Alexhuge1/Alexbotmini_hardware/1_Mechanic/Alexbotmini(SW2URDF)/4_Photos/alexbotmini_stand.jpg

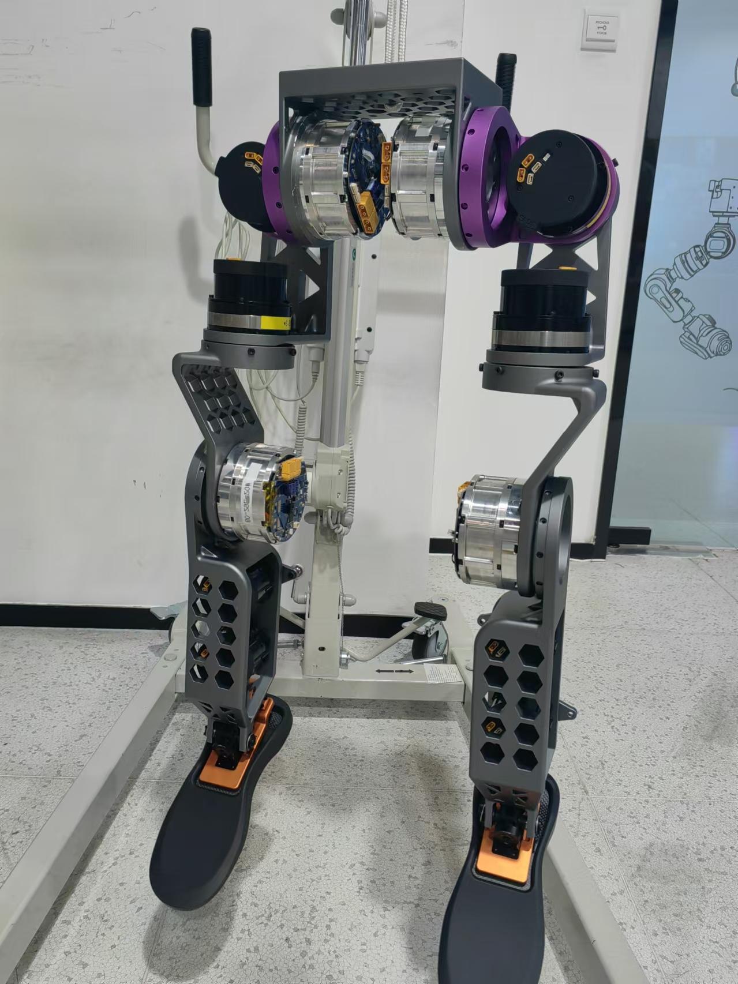
1_Mechanic/Alexbotmini(SW2URDF)/4_Photos/alexbotmini_stand.jpg
