Alexhuge1/Alexbotmini_hardware/1_Mechanic/Alexbotmini_website/Readme.txt

打开keyshot.23.html可以查看alexbotmini的建模文件
You can view the modeling files of Alexbotmini by opening keyshot.23.html.
