Alexhuge1/Alexbotmini_hardware/1_Mechanic/Alexbotmini(SW2URDF)/urdf_refine(mustread)！.pdf

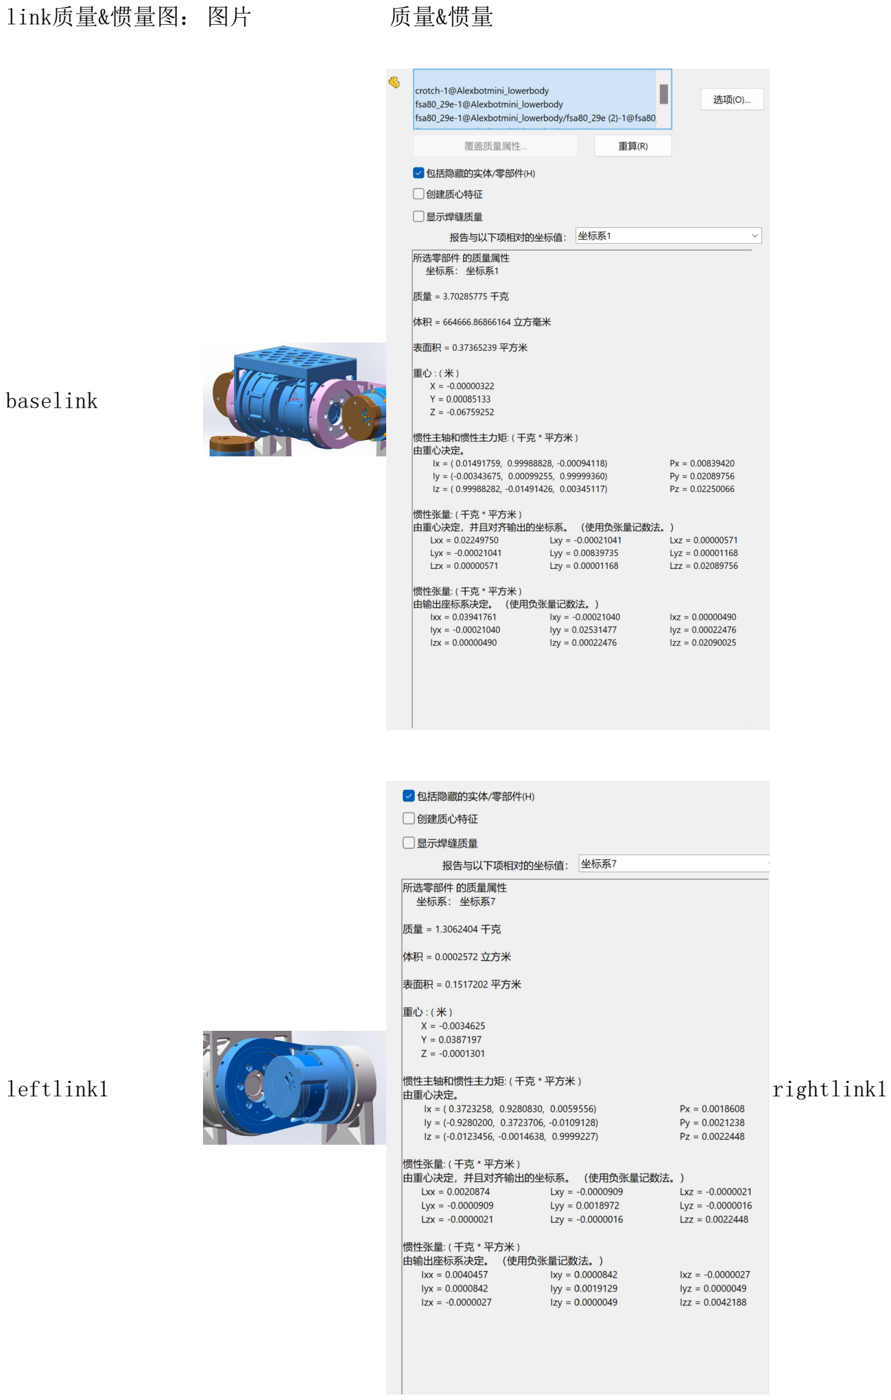
[picture p21: page 1]

link质量&惯量图： 图片 | 质量&惯量

baselink

leftlink1 | rightlink1

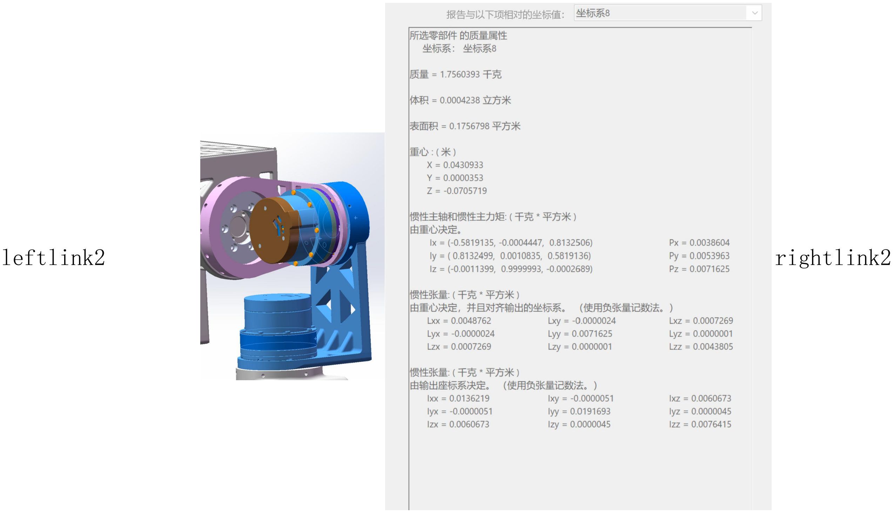
[picture p22: figure]
leftlink2; rightlink2
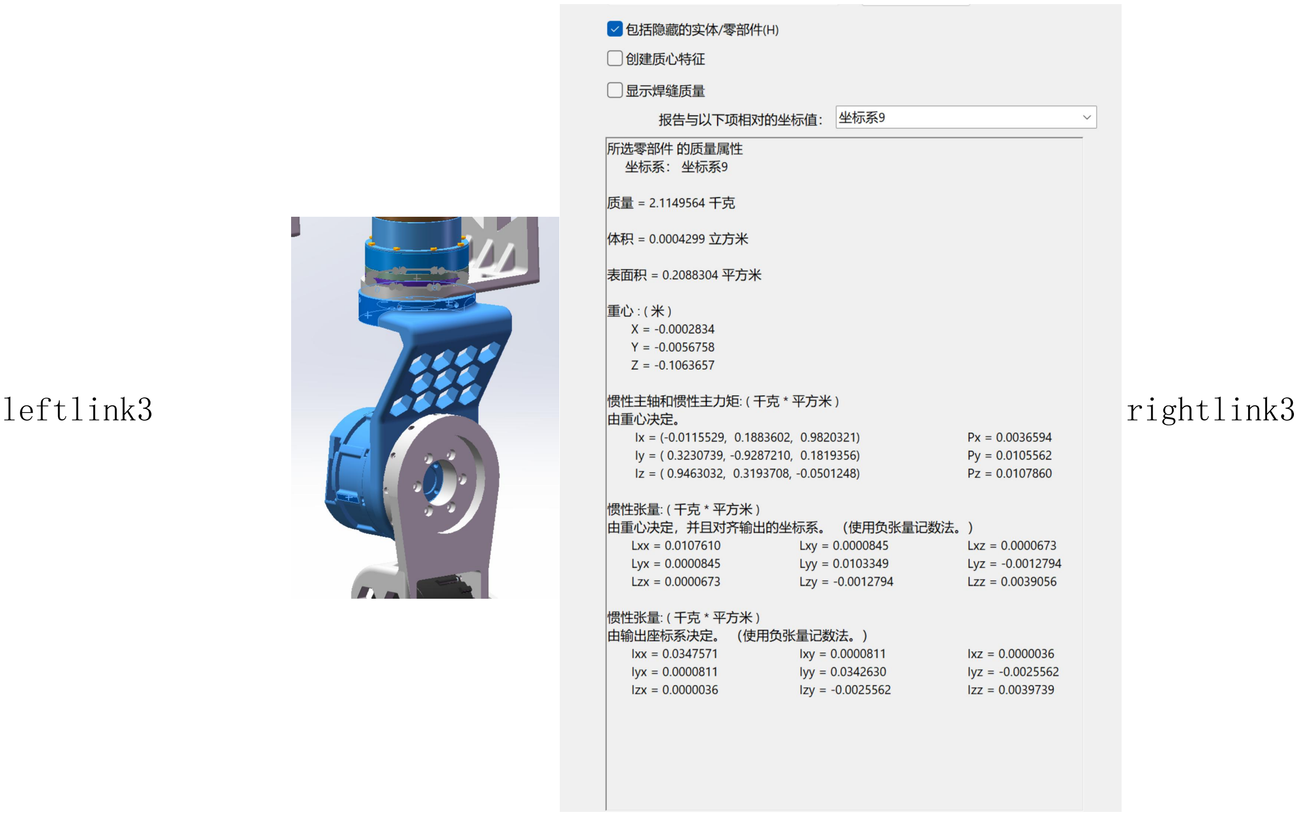
[picture p23: figure]
leftlink3; rightlink3
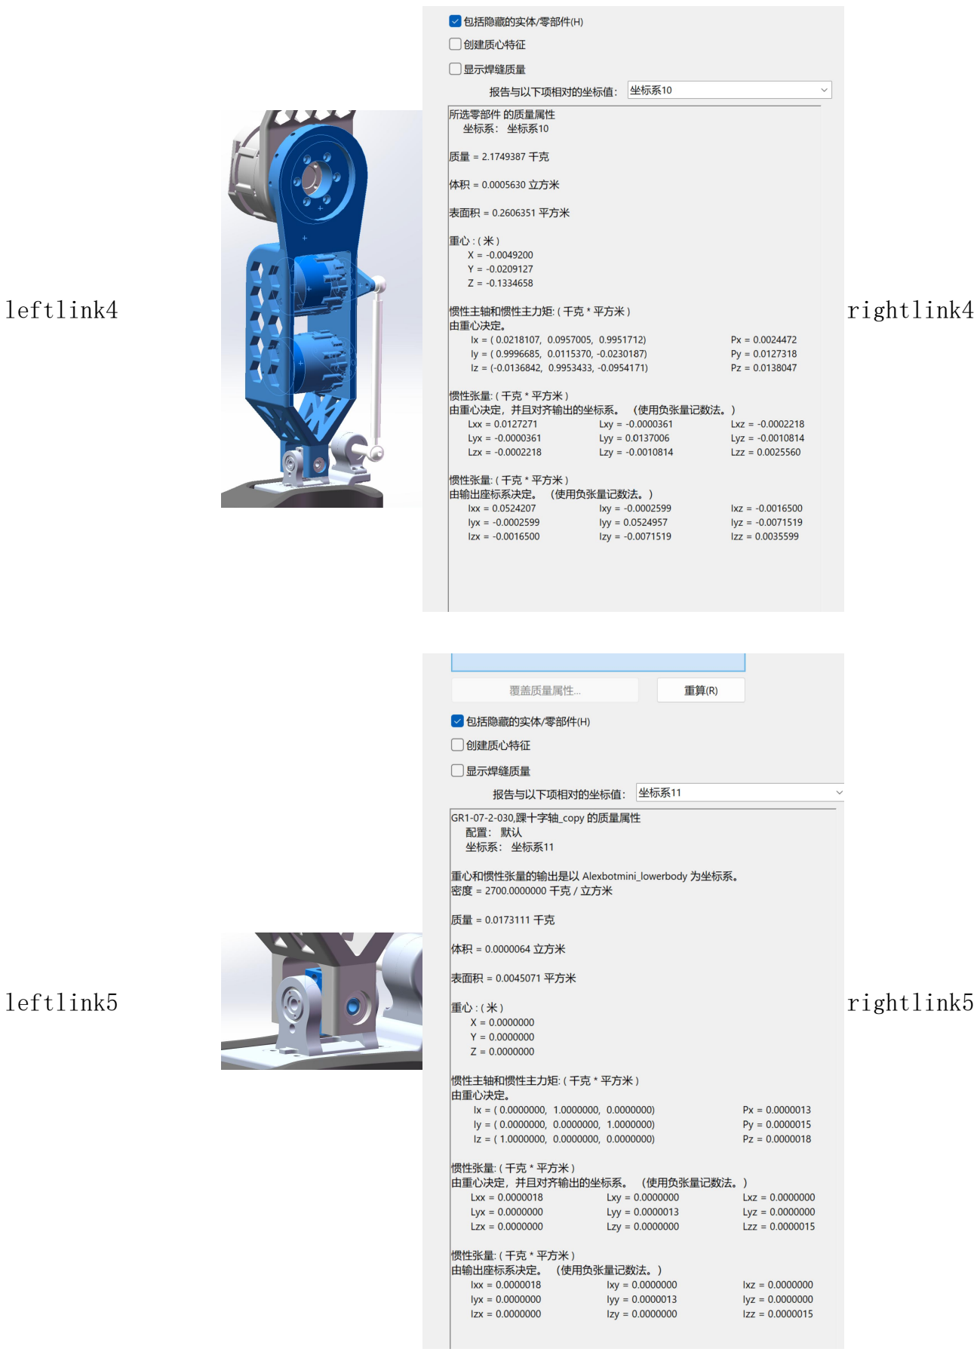
[picture p24: page 3]

leftlink4 | rightlink4
leftlink5 | rightlink5

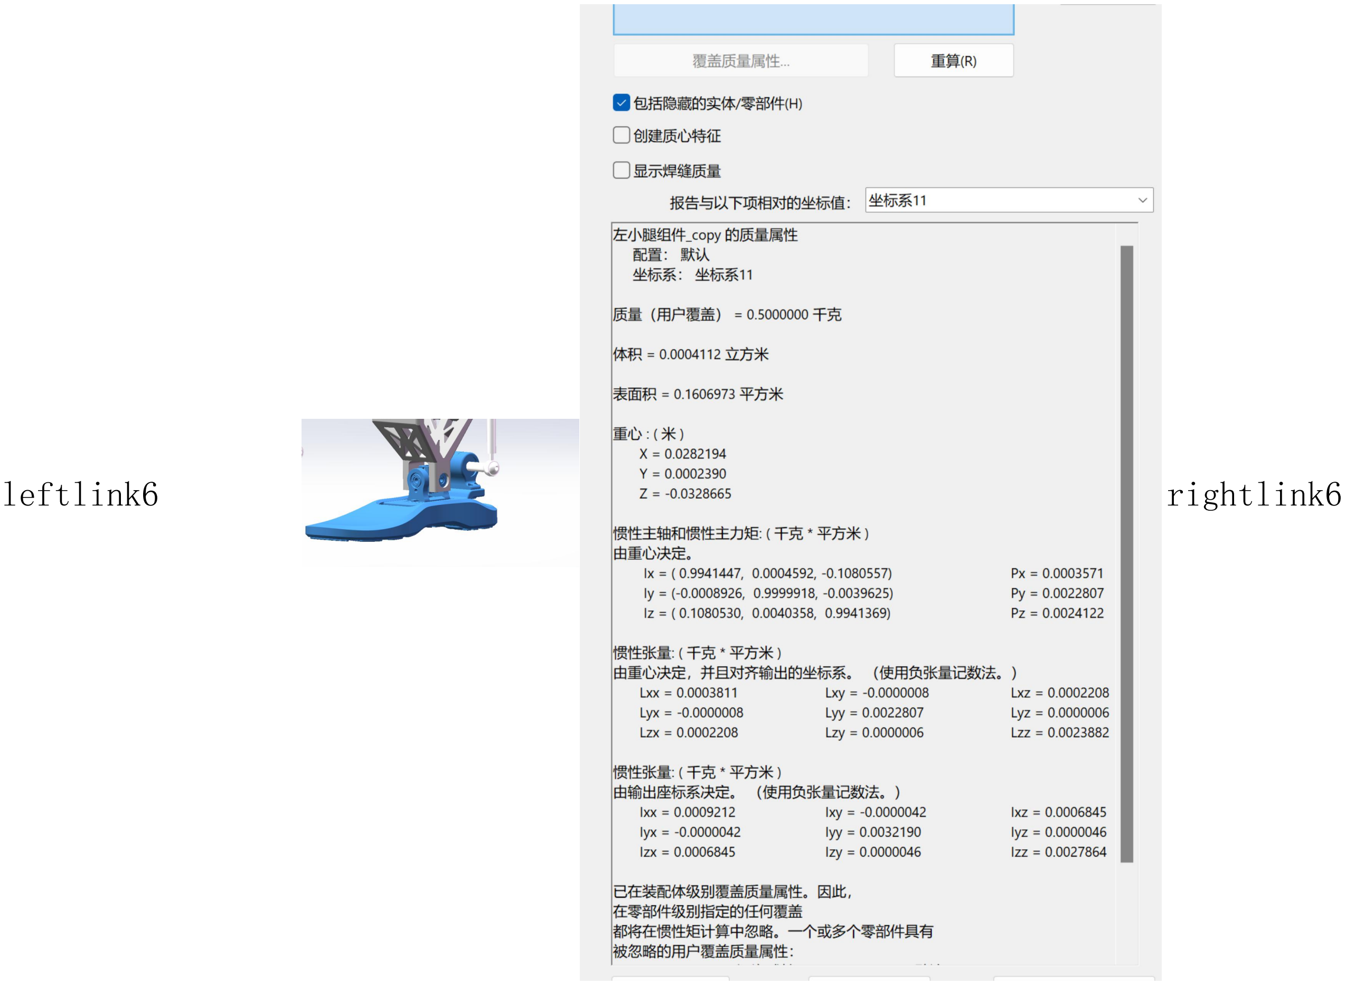
[picture p25: figure]
leftlink6; rightlink6

注意事项：1.更改坐标系，改为
你导出urdf的坐标系 2.更改负张
量计数法 3.注意单位：kg&m

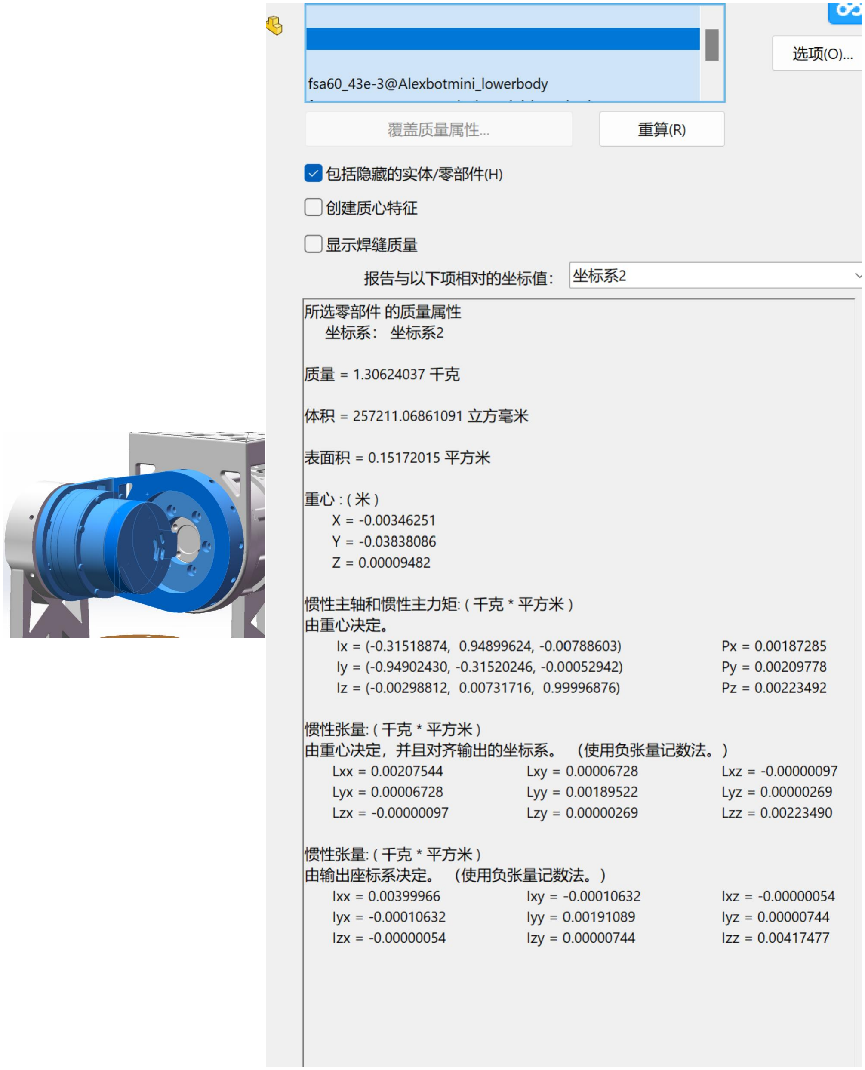
[picture p26: figure]

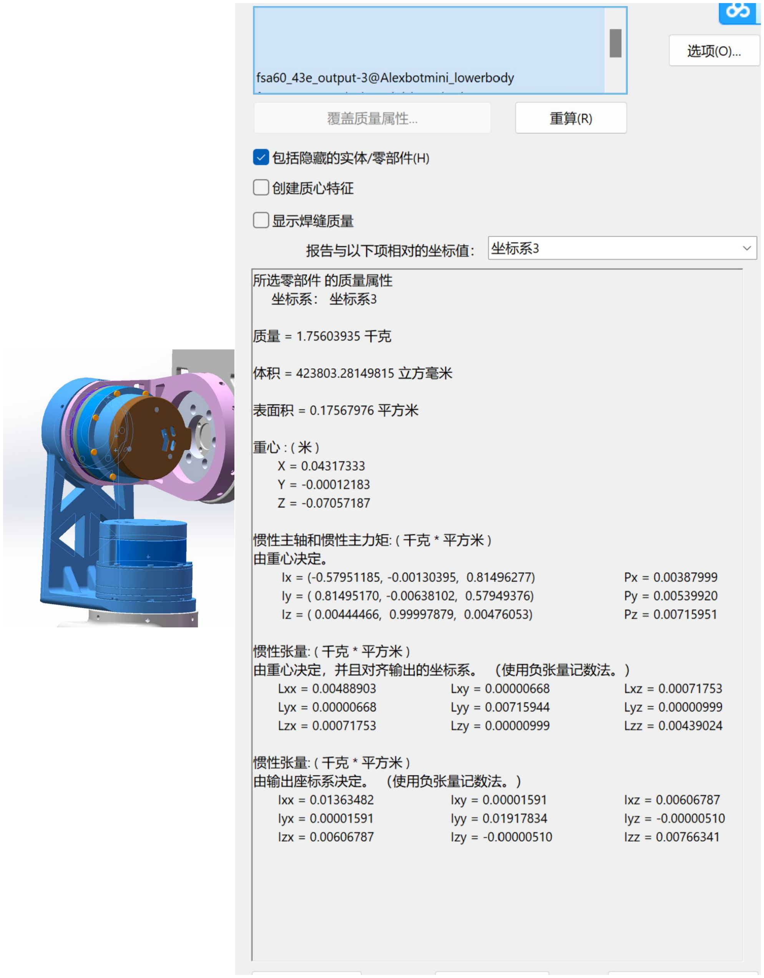
[picture p27: figure]
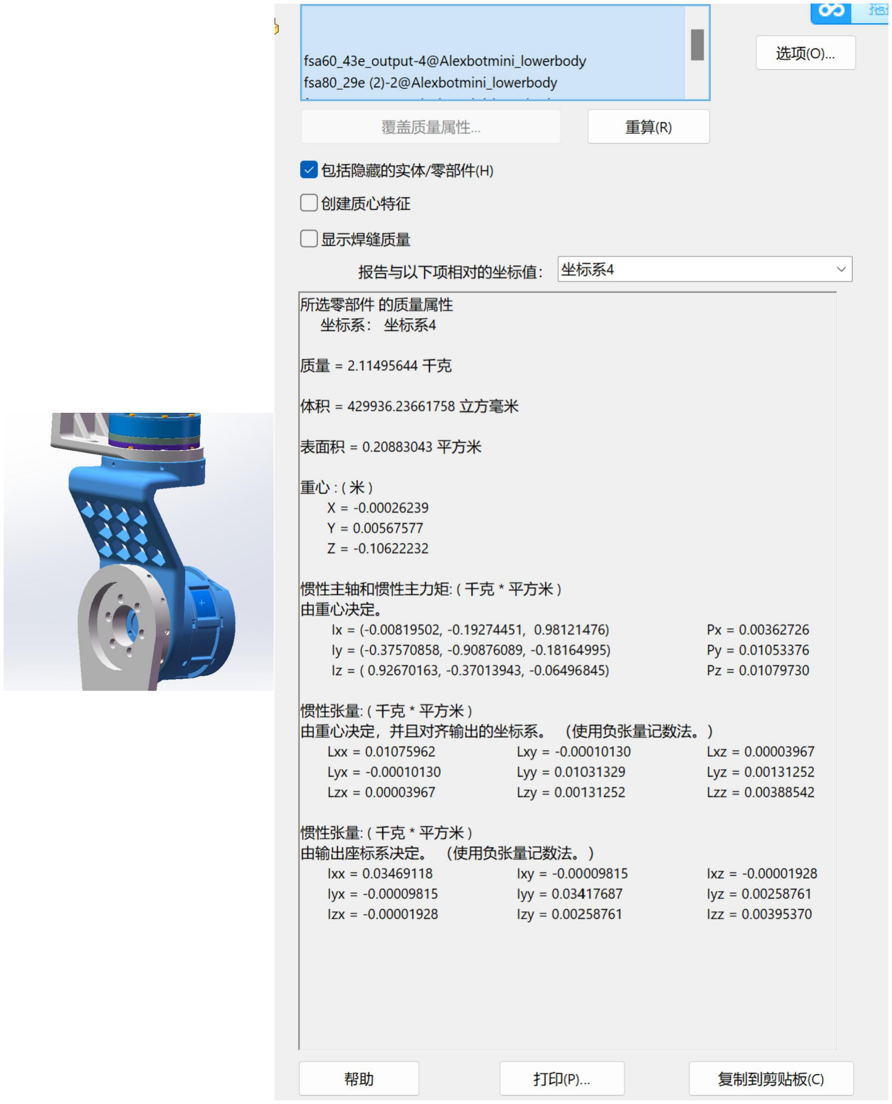
[picture p28: figure]

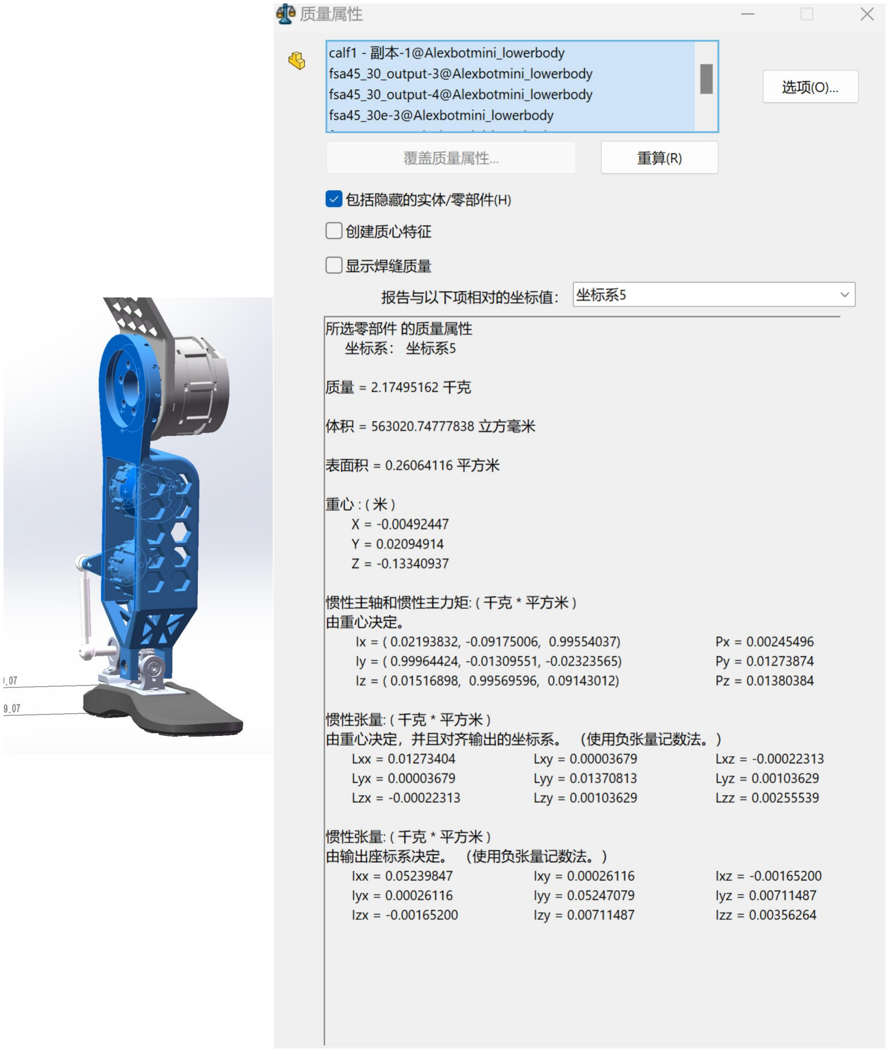
[picture p29: figure]
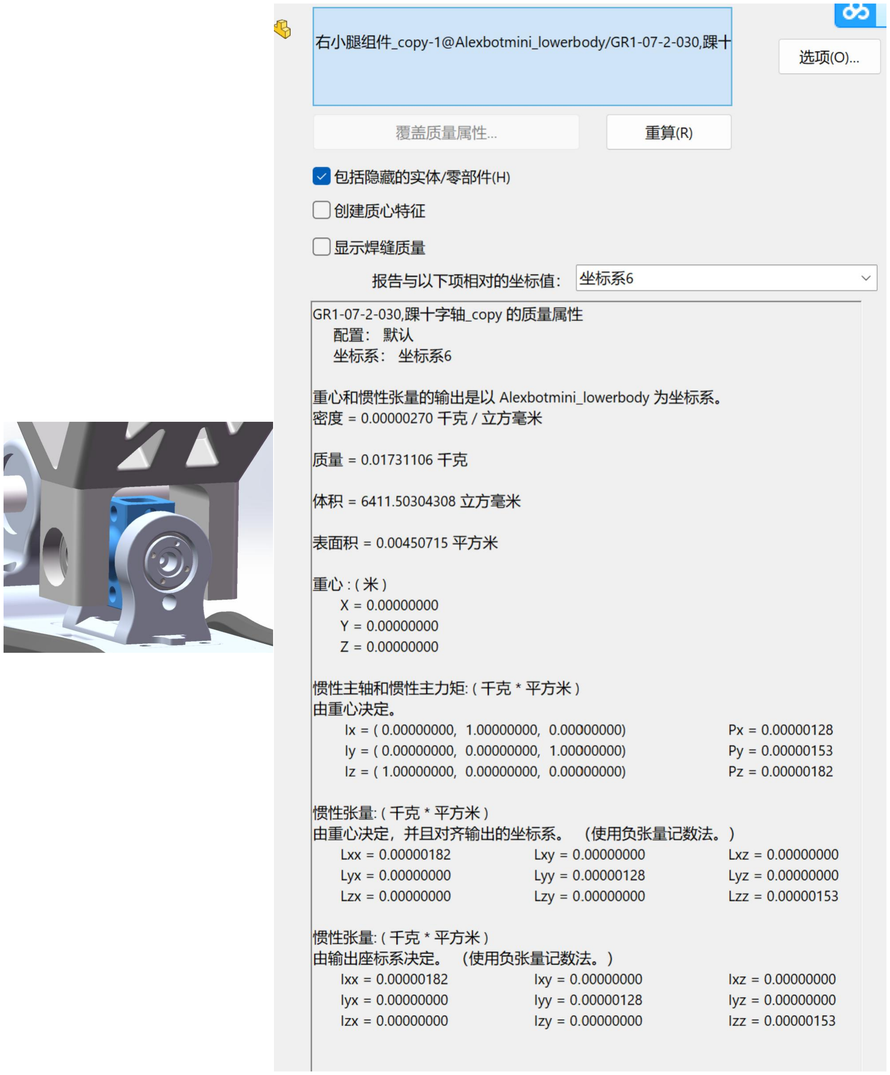
[picture p30: figure]

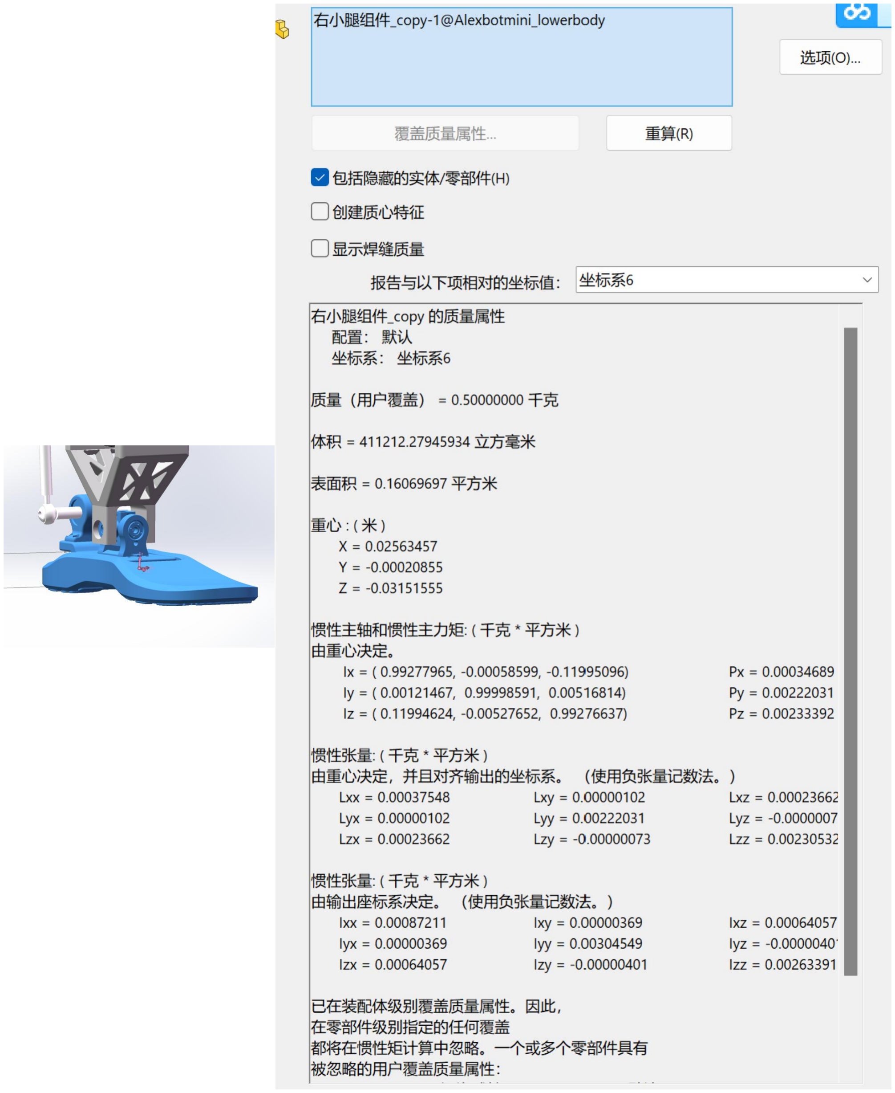
[picture p31: figure]
