Alexhuge1/Alexbotmini_hardware/1_Mechanic/Alexbotmini(SW2URDF)/urdf_refine(mustread)！.xlsx

link质量&惯量图： | 图片 | 质量&惯量
baselink | =DISPIMG("ID_1C0CE77E68E9425B958E1EDF86C95E6C",1) | =DISPIMG("ID_1FABB83D51D7494E9F8179027B9E1094",1) | 注意事项：1.更改坐标系，改为你导出urdf的坐标系 2.更改负张量计数法 3.注意单位：kg&m
leftlink1 | =DISPIMG("ID_44BA297711A545948F7443FFFF236D65",1) | =DISPIMG("ID_0A5D01F1CB4A430AA025BB64D2F1FC89",1) | rightlink1 | =DISPIMG("ID_5C1B6181500A4EAC9E08262F65AAD256",1) | =DISPIMG("ID_6D3B65C8E0194A66B9B3BC93D5BA8E26",1)
leftlink2 | =DISPIMG("ID_9AE7F1F97F734BC3A3421481E2FA2D89",1) | =DISPIMG("ID_DF5E5C27D4D14C22A94021531147BF48",1) | rightlink2 | =DISPIMG("ID_988EFCA75EA34A7E8A7768644050118C",1) | =DISPIMG("ID_4FAF0C96B3A447CCAF815983E6F93B1B",1)
leftlink3 | =DISPIMG("ID_097C6348B7B5493383EA53019D18FA08",1) | =DISPIMG("ID_459430F3A93A4EBC8D871A727542E844",1) | rightlink3 | =DISPIMG("ID_CE7CF34695F348FDA5A8E36F562161E4",1) | =DISPIMG("ID_73DCF52A318B454F904E86D190E805B4",1)
leftlink4 | =DISPIMG("ID_DF57CA10B41D4B2ABAE5A0ED66165A8E",1) | =DISPIMG("ID_58CDE301C7404CEE89BE275A6B768D47",1) | rightlink4 | =DISPIMG("ID_09F356C7827047E58FE56CFB3C1FC97D",1) | =DISPIMG("ID_C9C70A38E76549A2B665936A6316C4DD",1)
leftlink5 | =DISPIMG("ID_E7BCAD4DF211422F98E88A00787B6477",1) | =DISPIMG("ID_075E9A431DBB44F389FDC5FDDEC96E5B",1) | rightlink5 | =DISPIMG("ID_4BC1ECEBBFE74340B86422D74D7C38FF",1) | =DISPIMG("ID_04E541C0CE9548EF9C4D32182812DCA0",1)
leftlink6 | =DISPIMG("ID_66FF24A2B18E44D3B0DF6D6F0063CF89",1) | =DISPIMG("ID_82EB911DCF9543F5885EF4173C3C8441",1) | rightlink6 | =DISPIMG("ID_8553DB3B3BCC4D14BC448A7B72F7F42B",1) | =DISPIMG("ID_ED9B58248A6C4E079C487C52EBD1B7BF",1)
