Alexhuge1/Alexbotmini_hardware/1_Mechanic/Alexbotmini(SW2URDF)/4_Photos/alexbotmini(3D).jpg

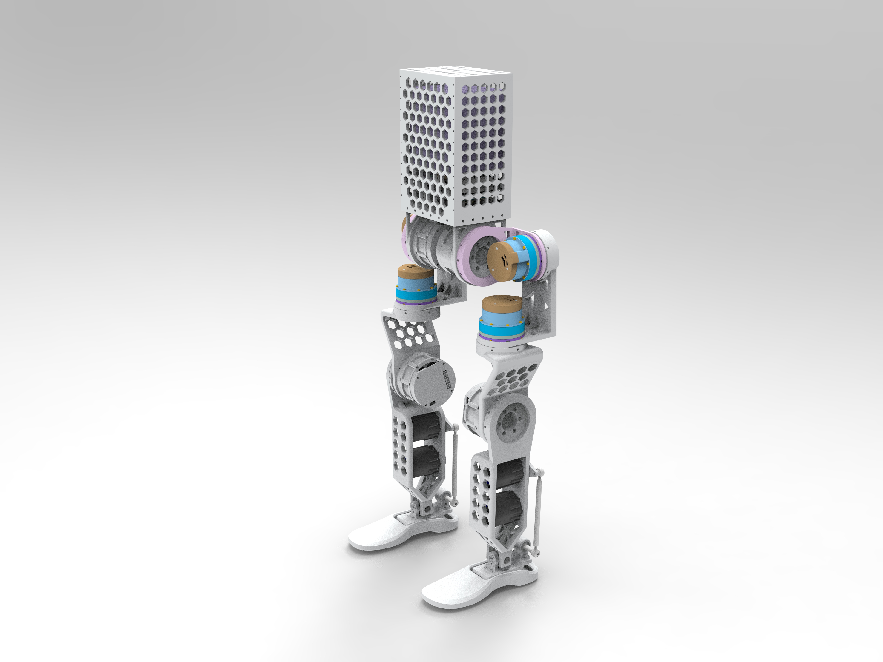
1_Mechanic/Alexbotmini(SW2URDF)/4_Photos/alexbotmini(3D).jpg
