Alexhuge1/Alexbotmini_hardware/1_Mechanic/Alexbotmini(SW2URDF)/4_Photos/back.jpg

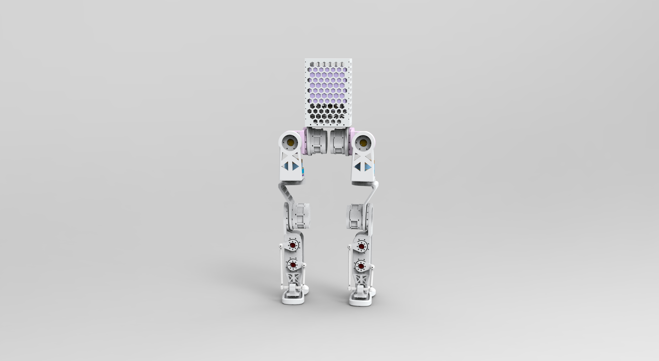
1_Mechanic/Alexbotmini(SW2URDF)/4_Photos/back.jpg
