Alexhuge1/Alexbotmini_hardware/1_Mechanic/Alexbotmini(SW2URDF)/4_Photos/left.jpg

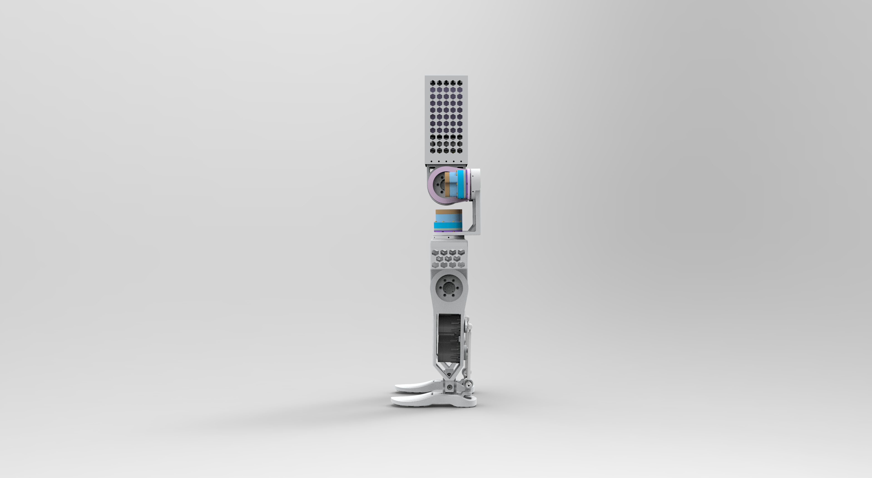
1_Mechanic/Alexbotmini(SW2URDF)/4_Photos/left.jpg
