Alexhuge1/Alexbotmini_hardware/1_Mechanic/Alexbotmini_website/keyshot.23/files/xr_hand.gif

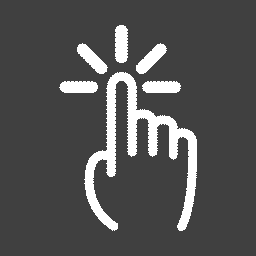
1_Mechanic/Alexbotmini_website/keyshot.23/files/xr_hand.gif
