Alexhuge1/Alexbotmini_hardware/1_Mechanic/SolidWorks_Flexnet_Server/激活失效解决方法.jpg

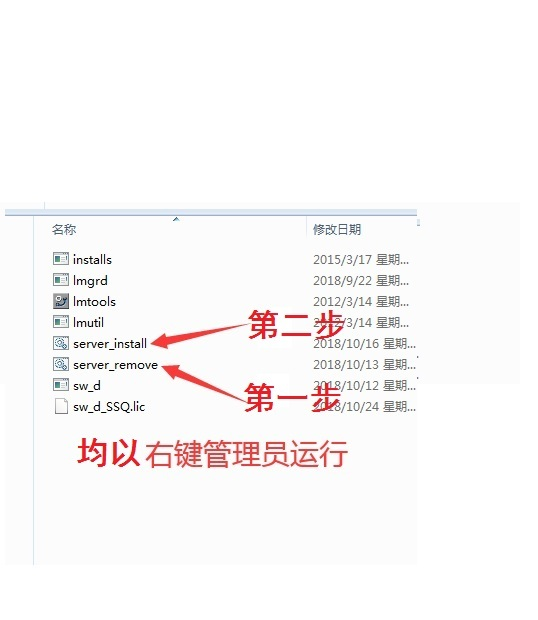
1_Mechanic/SolidWorks_Flexnet_Server/激活失效解决方法.jpg
