Alexhuge1/Alexbotmini_hardware/2_Firmware/imu/products-master/examples/linux/img/1.png

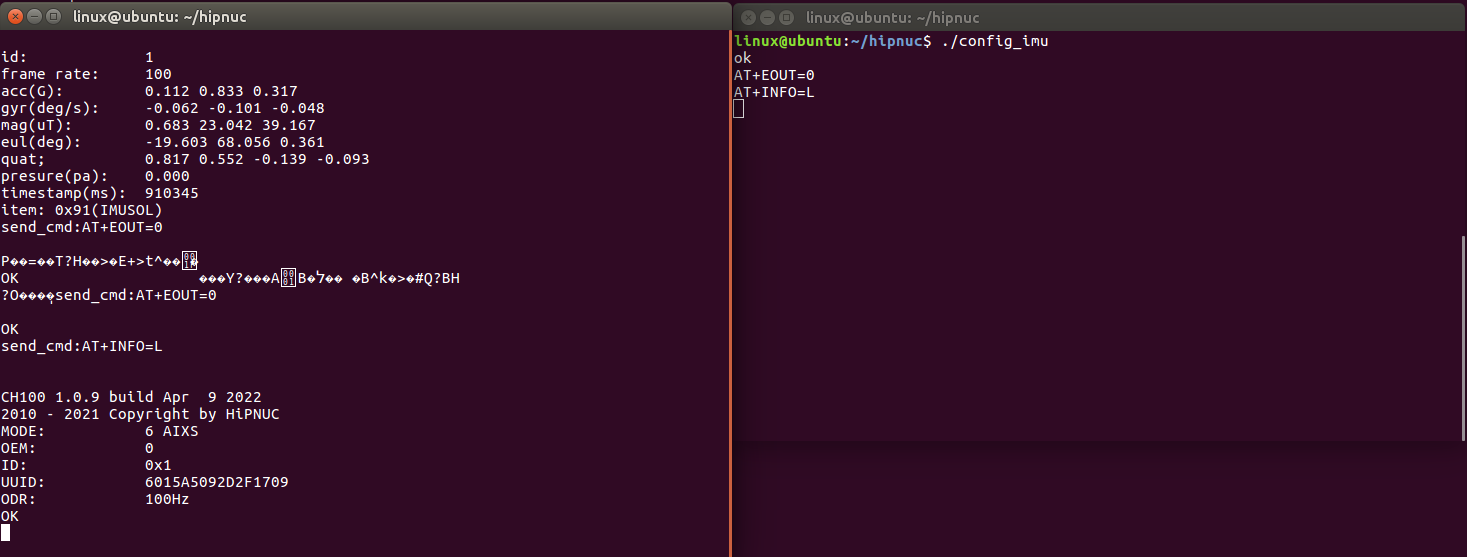
2_Firmware/imu/products-master/examples/linux/img/1.png
