Alexhuge1/Alexbotmini_hardware/2_Firmware/imu/products-master/examples/ROS2/img/2.png

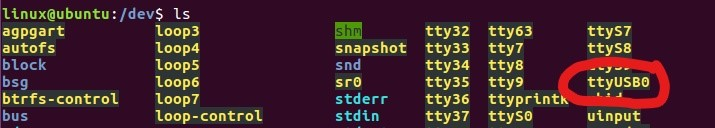
2_Firmware/imu/products-master/examples/ROS2/img/2.png
