Alexhuge1/Alexbotmini_hardware/2_Firmware/imu/products-master/examples/ROS_Melodic/img/4.png

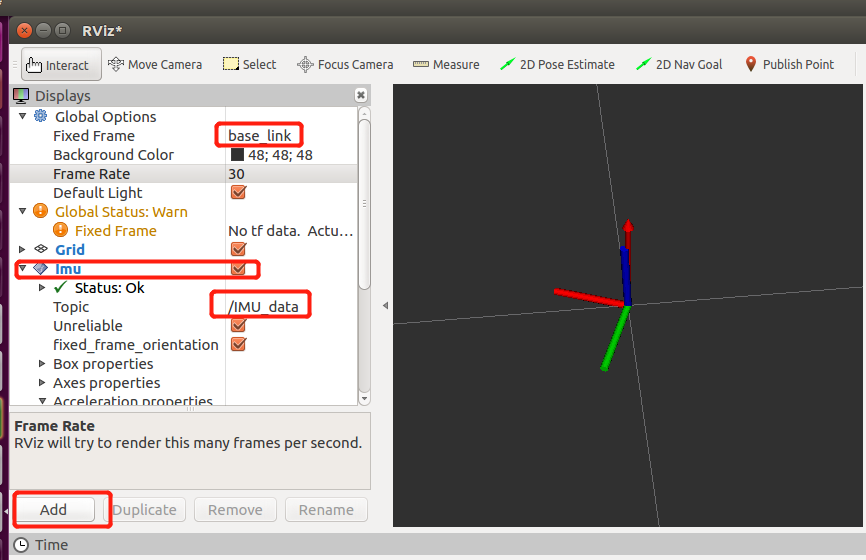
2_Firmware/imu/products-master/examples/ROS_Melodic/img/4.png
