Alexhuge1/Alexbotmini_hardware/2_Firmware/imu/products-master/img/qr_qqq.jpg

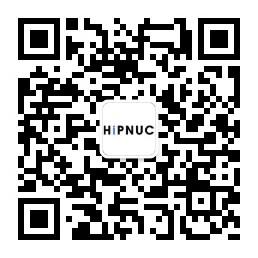
2_Firmware/imu/products-master/img/qr_qqq.jpg
