Alexhuge1/Alexbotmini_hardware/2_Firmware/joystick/ps5手柄.jpg

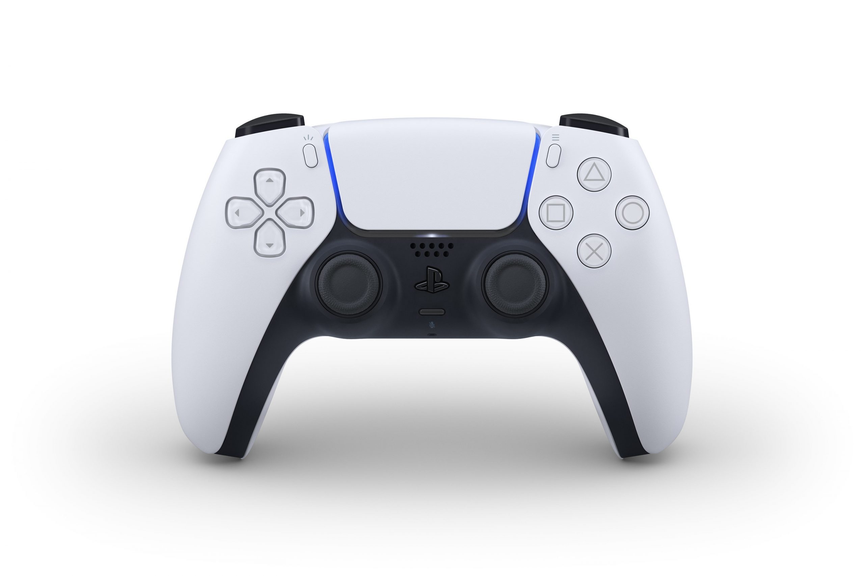
2_Firmware/joystick/ps5手柄.jpg
