Alexhuge1/Alexbotmini_hardware/3_Docs&Photos/Full-body proportion of the robot..png

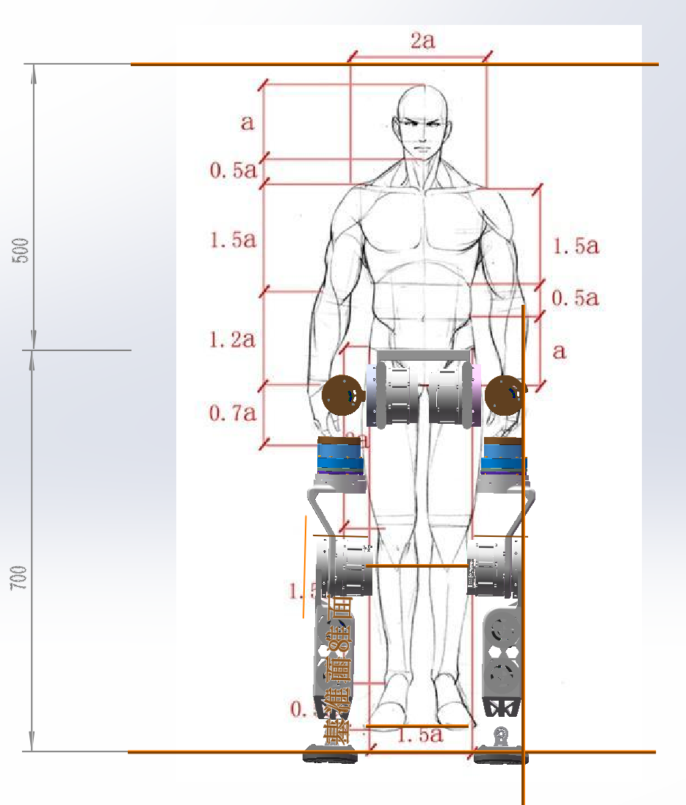
3_Docs&Photos/Full-body proportion of the robot..png
