Alexhuge1/Alexbotmini_hardware/3_Docs&Photos/upperbody (2).jpg

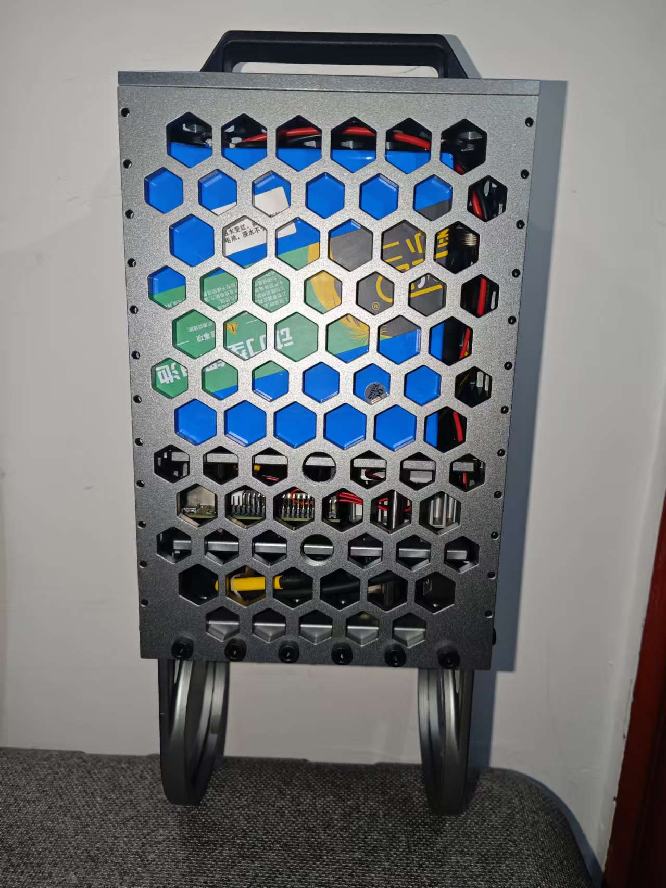
3_Docs&Photos/upperbody (2).jpg
