Alexhuge1/Alexbotmini_hardware/3_Docs&Photos/upperbody.jpg

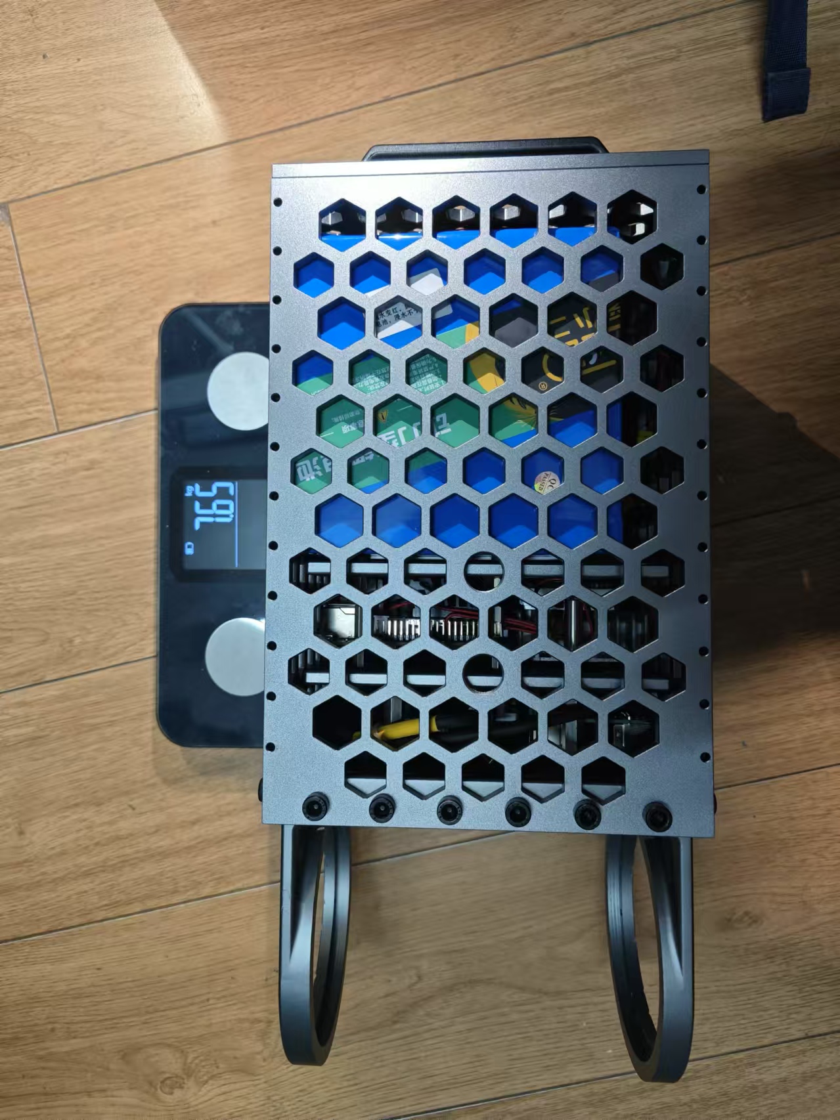
3_Docs&Photos/upperbody.jpg
