Alexhuge1/Alexbotmini_hardware/3_Docs&Photos/V1lowerbody.jpg

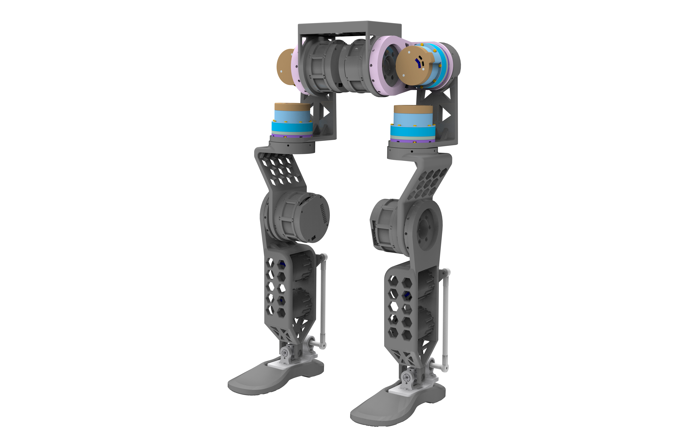
3_Docs&Photos/V1lowerbody.jpg
