Alexhuge1/Alexbotmini_hardware/1_Mechanic/Alexbotmini(SW2URDF)/1_Lowerbody/左小腿组件_copy.SLDASM

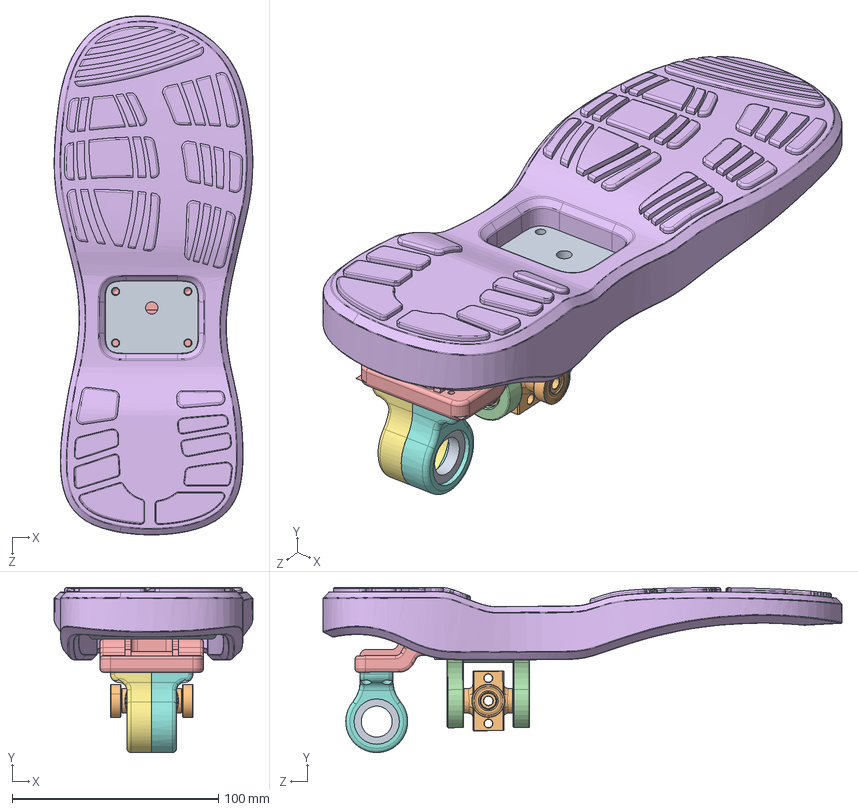
[picture p47: CAD file, 2025-01-23]
1_Mechanic/Alexbotmini(SW2URDF)/1_Lowerbody/左小腿组件_copy.SLDASM
96.2 x 80.0 x 251.4 mm
GR1-07-2-030,踝十字轴_copy
GR1-07-2-033,关节延长轴_copy x 2
GR1-07-2-034-G,脚板十字座_copy
GR1-07-2-049-G,脚板转接件_copy
碳纤维板_copy
硅胶脚0418_copy
GR1-07-2-017-G,脚板连杆座_copy
GR1-07-2-059-G,脚板连杆座-1_copy
SC-BEAR-6802-ZZ,深沟球轴承6802_copy x 2
SC-BEAR-628-8,深沟球轴承628-8_copy x 4
