Alexhuge1/Alexbotmini_hardware/1_Mechanic/Alexbotmini(SW2URDF)/2_Wholebody/碳纤维板_copy.SLDPRT

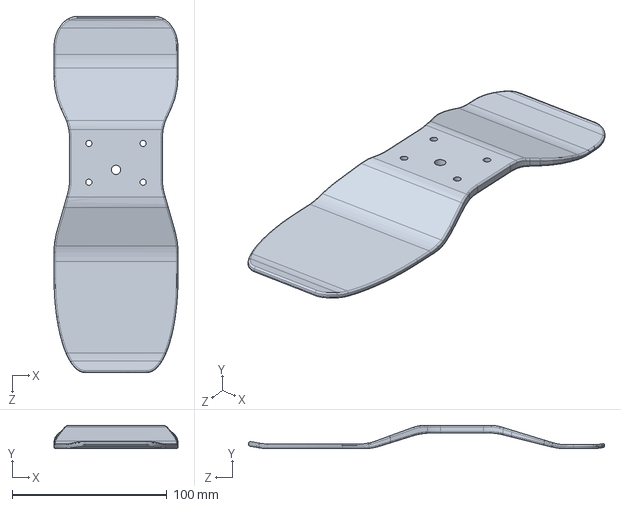
[picture p48: CAD file, 2024-12-04]
1_Mechanic/Alexbotmini(SW2URDF)/2_Wholebody/碳纤维板_copy.SLDPRT
80.0 x 15.0 x 229.8 mm
