Alexhuge1/Alexbotmini_hardware/1_Mechanic/Alexbotmini(SW2URDF)/3_For_CNC/3D/front.SLDPRT

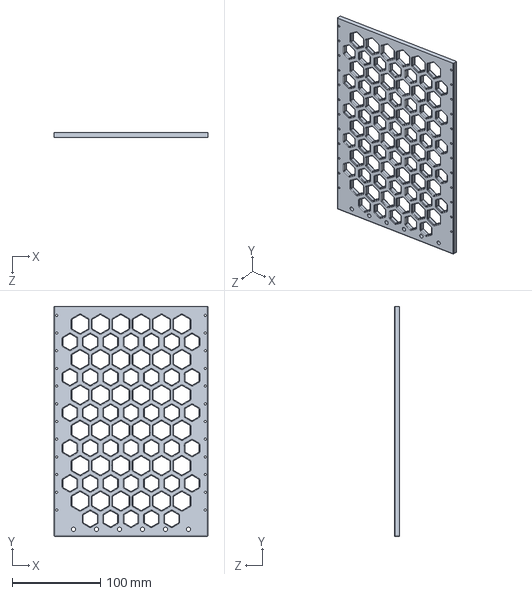
[picture p49: CAD file, 2024-12-04]
1_Mechanic/Alexbotmini(SW2URDF)/3_For_CNC/3D/front.SLDPRT
174.0 x 260.0 x 6.00 mm
