Alexhuge1/Alexbotmini_hardware/1_Mechanic/Alexbotmini(SW2URDF)/3_For_CNC/step/crotch.STEP

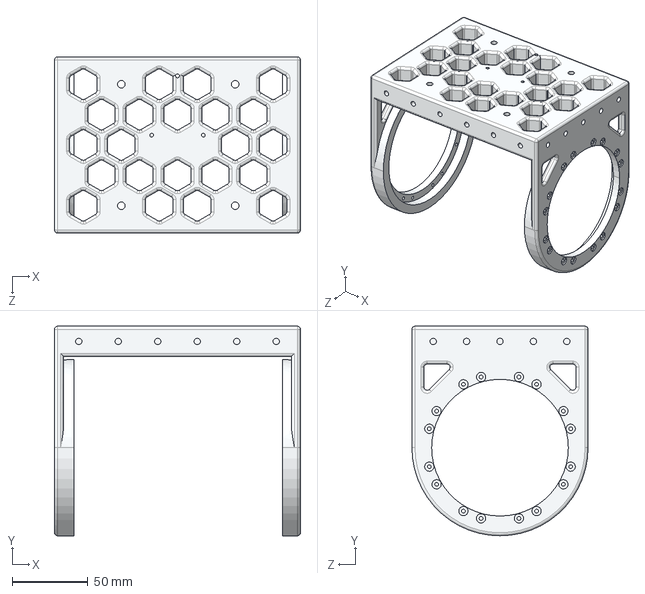
[picture p50: CAD file, 2024-12-04]
1_Mechanic/Alexbotmini(SW2URDF)/3_For_CNC/step/crotch.STEP
162.0 x 138.0 x 116.0 mm
