Alexhuge1/Alexbotmini_hardware/1_Mechanic/Alexbotmini(SW2URDF)/1_Lowerbody/GR1-07-2-030,踝十字轴_copy.SLDPRT

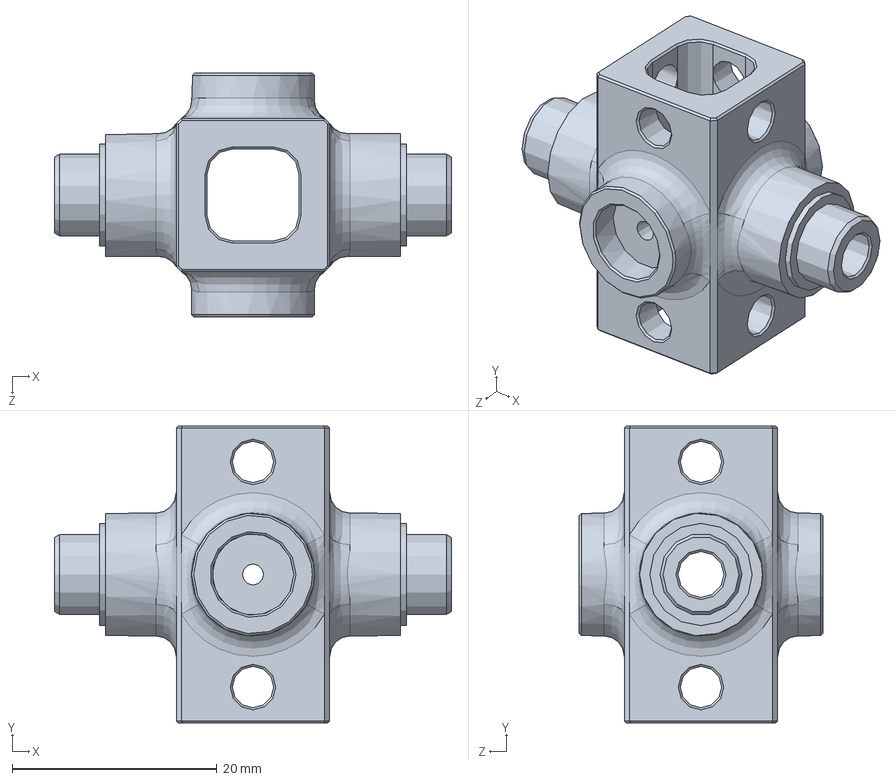
[picture p51: CAD file, 2025-01-23]
1_Mechanic/Alexbotmini(SW2URDF)/1_Lowerbody/GR1-07-2-030,踝十字轴_copy.SLDPRT
38.8 x 29.0 x 23.8 mm
