Alexhuge1/Alexbotmini_hardware/1_Mechanic/Alexbotmini(SW2URDF)/2_Wholebody/GR1-07-2-049-G,脚板转接件_copy.SLDPRT

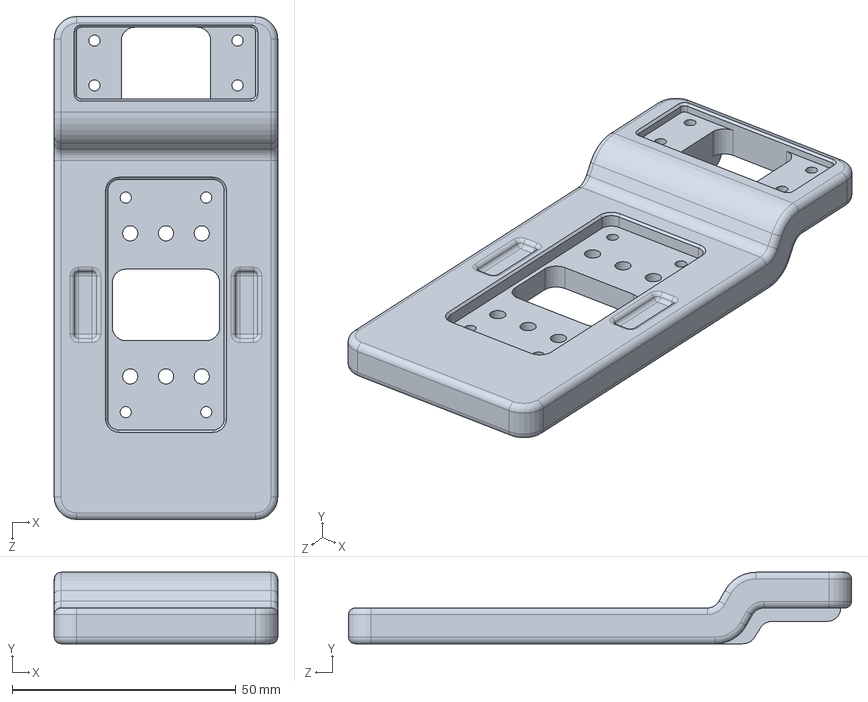
[picture p52: CAD file, 2024-12-04]
1_Mechanic/Alexbotmini(SW2URDF)/2_Wholebody/GR1-07-2-049-G,脚板转接件_copy.SLDPRT
50.0 x 16.0 x 112.5 mm
