Alexhuge1/Alexbotmini_hardware/1_Mechanic/Alexbotmini(SW2URDF)/3_For_CNC/step/knee.step

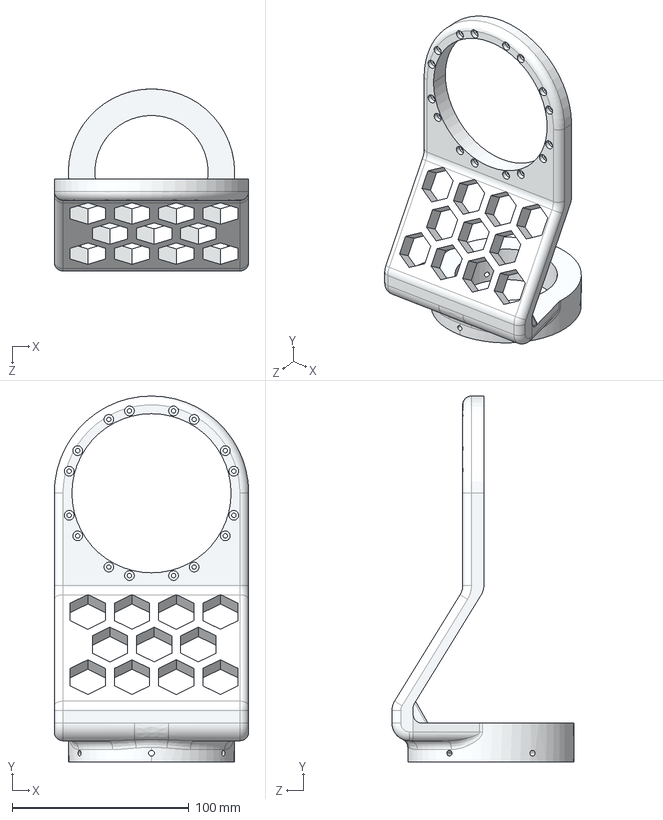
[picture p54: CAD file, 2024-12-04]
1_Mechanic/Alexbotmini(SW2URDF)/3_For_CNC/step/knee.step
110.0 x 207.0 x 103.0 mm
