Alexhuge1/Alexbotmini_hardware/1_Mechanic/Alexbotmini(SW2URDF)/1_Lowerbody/M5球头.SLDPRT

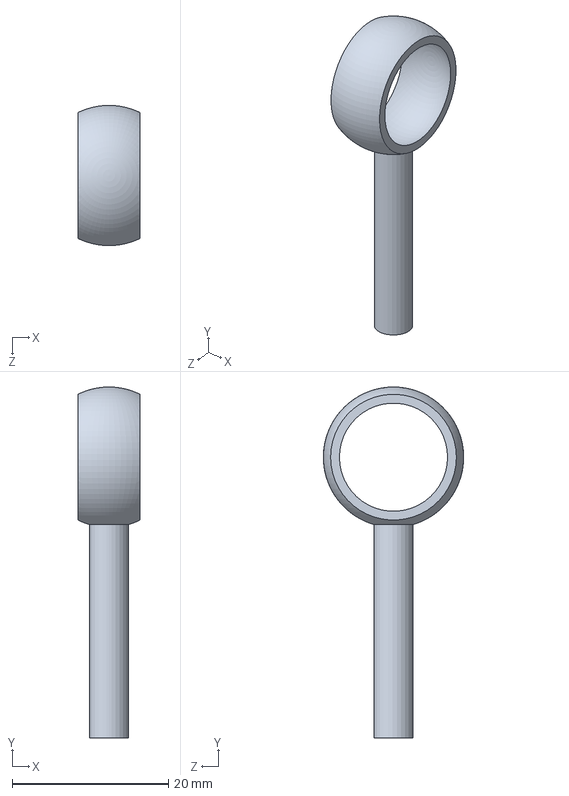
[picture p55: CAD file, 2024-12-04]
1_Mechanic/Alexbotmini(SW2URDF)/1_Lowerbody/M5球头.SLDPRT
8.00 x 45.0 x 18.0 mm
