Alexhuge1/Alexbotmini_hardware/1_Mechanic/Alexbotmini(SW2URDF)/2_Wholebody/fsa60_43e_output.SLDPRT

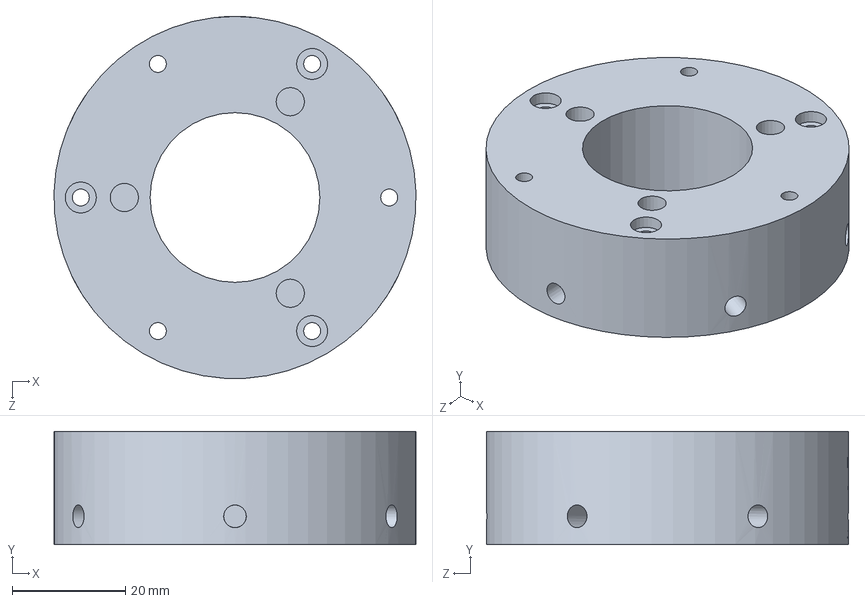
[picture p56: CAD file, 2024-12-04]
1_Mechanic/Alexbotmini(SW2URDF)/2_Wholebody/fsa60_43e_output.SLDPRT
64.0 x 20.0 x 64.0 mm
