Alexhuge1/Alexbotmini_hardware/1_Mechanic/Alexbotmini(SW2URDF)/3_For_CNC/3D/ctrlbox.SLDPRT

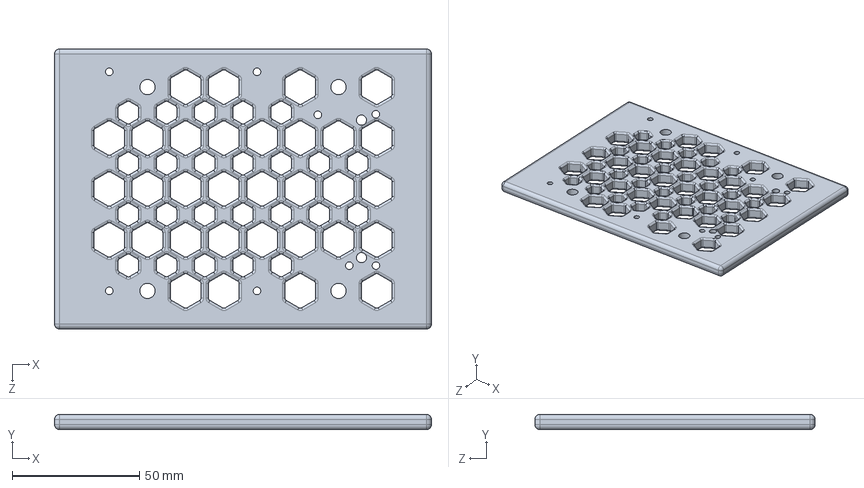
[picture p57: CAD file, 2024-12-04]
1_Mechanic/Alexbotmini(SW2URDF)/3_For_CNC/3D/ctrlbox.SLDPRT
148.0 x 6.00 x 110.0 mm
