Alexhuge1/Alexbotmini_hardware/1_Mechanic/Alexbotmini(SW2URDF)/3_For_CNC/step/fsa80_29e_output_long.step

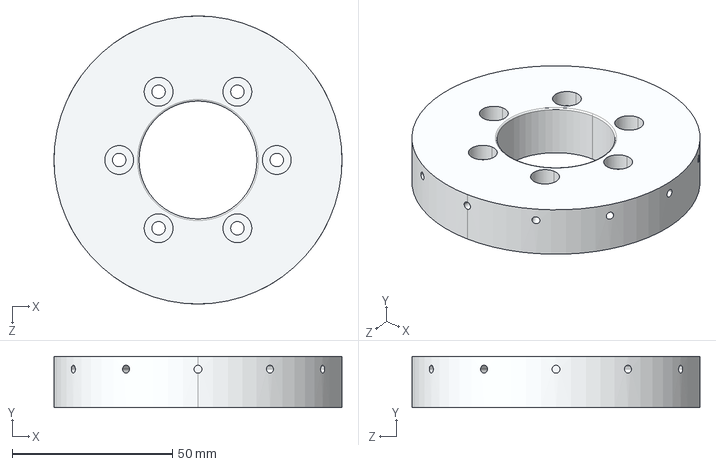
[picture p58: CAD file, 2024-12-04]
1_Mechanic/Alexbotmini(SW2URDF)/3_For_CNC/step/fsa80_29e_output_long.step
89.9 x 16.0 x 89.9 mm
