Alexhuge1/Alexbotmini_hardware/1_Mechanic/Alexbotmini(SW2URDF)/1_Lowerbody/球轴承.SLDPRT

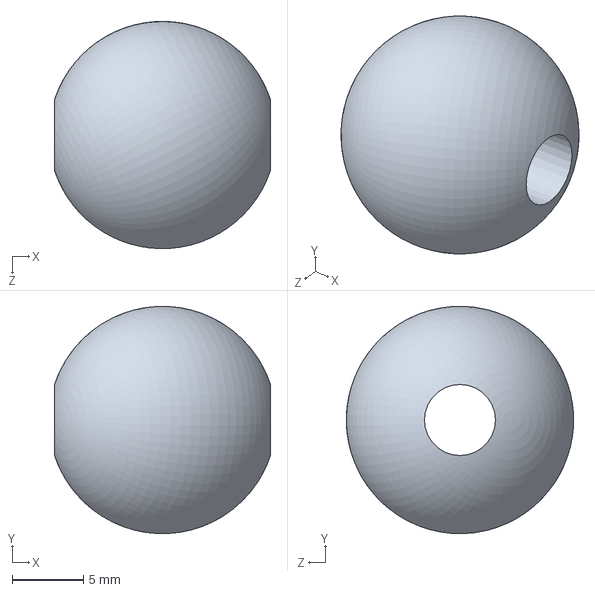
[picture p59: CAD file, 2024-12-04]
1_Mechanic/Alexbotmini(SW2URDF)/1_Lowerbody/球轴承.SLDPRT
15.2 x 16.0 x 16.0 mm
