Alexhuge1/Alexbotmini_hardware/1_Mechanic/Alexbotmini(SW2URDF)/2_Wholebody/M3螺柱10.SLDPRT

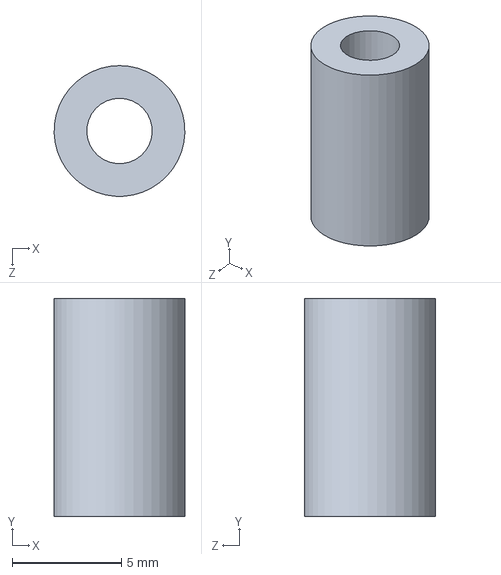
[picture p60: CAD file, 2024-12-04]
1_Mechanic/Alexbotmini(SW2URDF)/2_Wholebody/M3螺柱10.SLDPRT
6.00 x 10.0 x 6.00 mm
