Alexhuge1/Alexbotmini_hardware/1_Mechanic/Alexbotmini(SW2URDF)/3_For_CNC/step/fsa80_29e_output.step

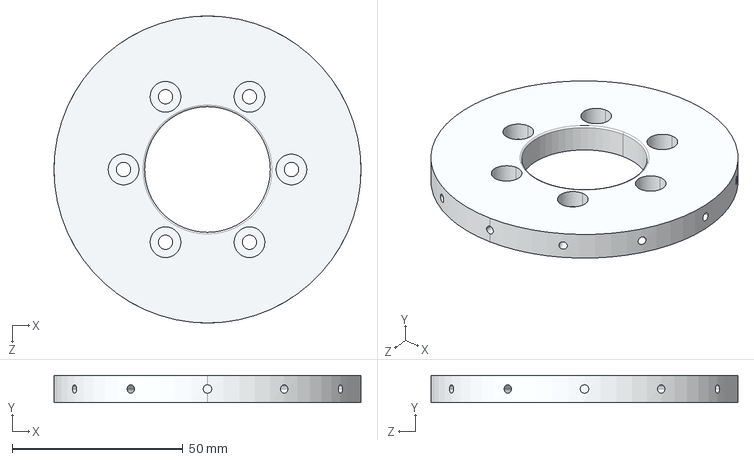
[picture p61: CAD file, 2024-12-04]
1_Mechanic/Alexbotmini(SW2URDF)/3_For_CNC/step/fsa80_29e_output.step
90.0 x 8.00 x 90.0 mm
