Alexhuge1/Alexbotmini_hardware/1_Mechanic/Alexbotmini(SW2URDF)/1_Lowerbody/calf1.SLDPRT

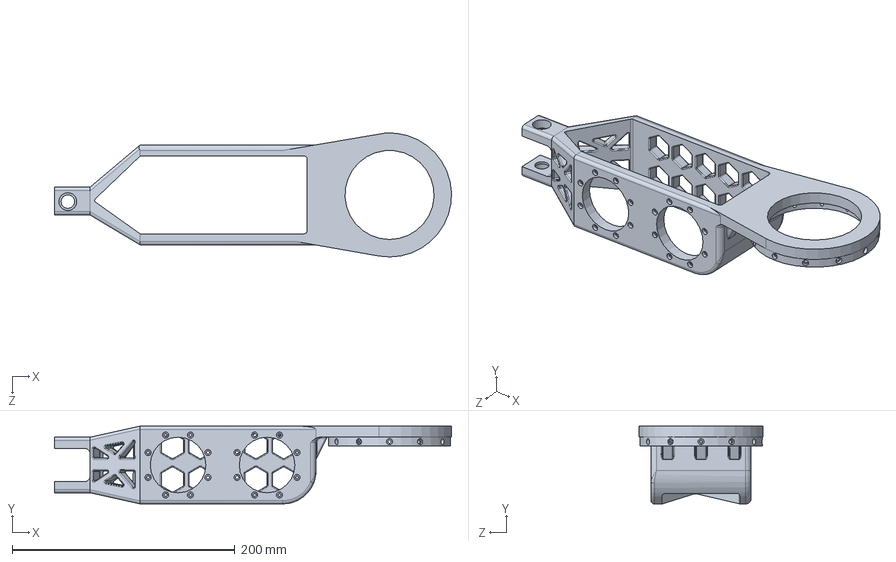
[picture p62: CAD file, 2024-12-04]
1_Mechanic/Alexbotmini(SW2URDF)/1_Lowerbody/calf1.SLDPRT
356.7 x 70.0 x 111.3 mm
