Alexhuge1/Alexbotmini_hardware/1_Mechanic/Alexbotmini(SW2URDF)/2_Wholebody/fsa45_30_output.SLDPRT

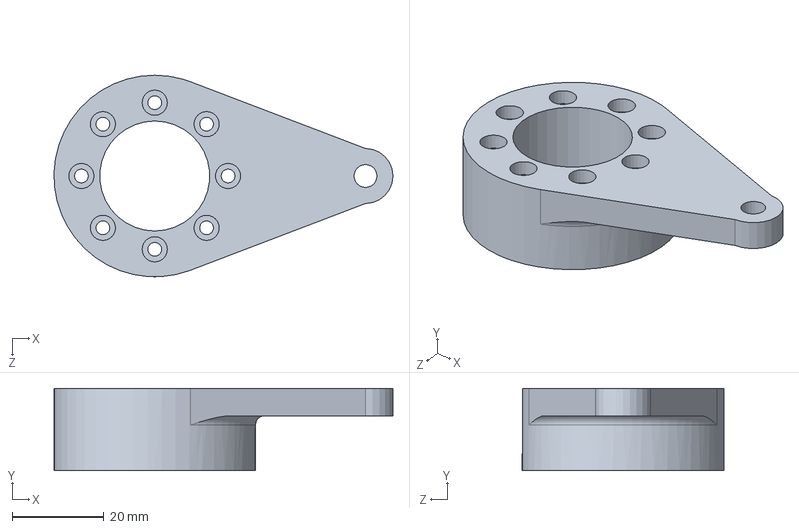
[picture p63: CAD file, 2024-12-04]
1_Mechanic/Alexbotmini(SW2URDF)/2_Wholebody/fsa45_30_output.SLDPRT
74.0 x 18.0 x 44.0 mm
