Alexhuge1/Alexbotmini_hardware/1_Mechanic/Alexbotmini(SW2URDF)/2_Wholebody/thigh1.SLDPRT

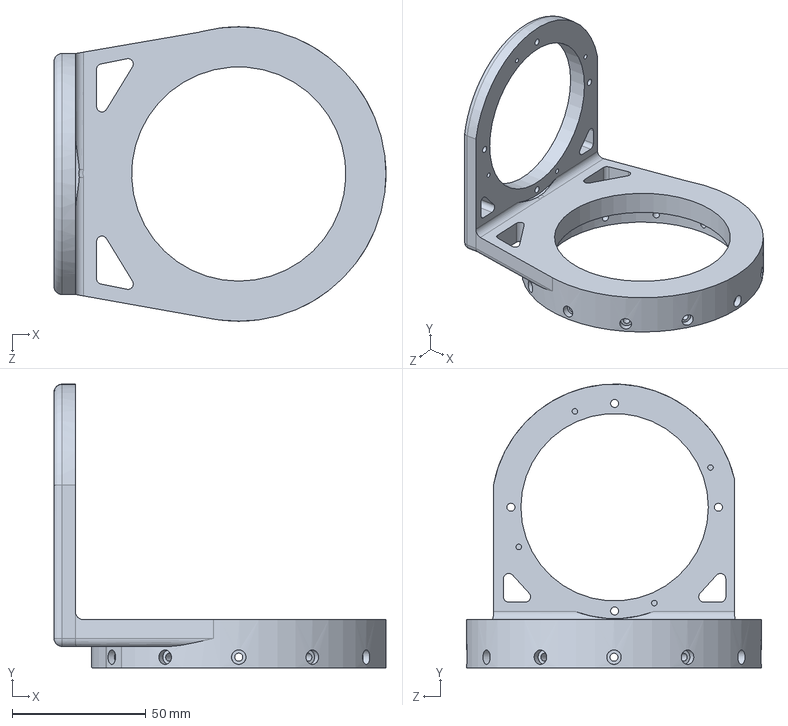
[picture p64: CAD file, 2024-12-04]
1_Mechanic/Alexbotmini(SW2URDF)/2_Wholebody/thigh1.SLDPRT
124.0 x 106.0 x 110.0 mm
