Alexhuge1/Alexbotmini_hardware/1_Mechanic/Alexbotmini(SW2URDF)/3_For_CNC/3D/top.SLDPRT

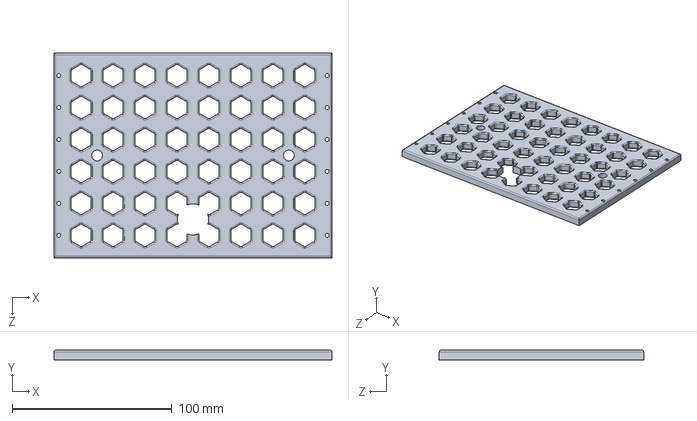
[picture p65: CAD file, 2024-12-04]
1_Mechanic/Alexbotmini(SW2URDF)/3_For_CNC/3D/top.SLDPRT
174.0 x 6.00 x 128.0 mm
