Alexhuge1/Alexbotmini_hardware/1_Mechanic/Alexbotmini(SW2URDF)/1_Lowerbody/GR1-07-2-033,关节延长轴_copy.SLDPRT

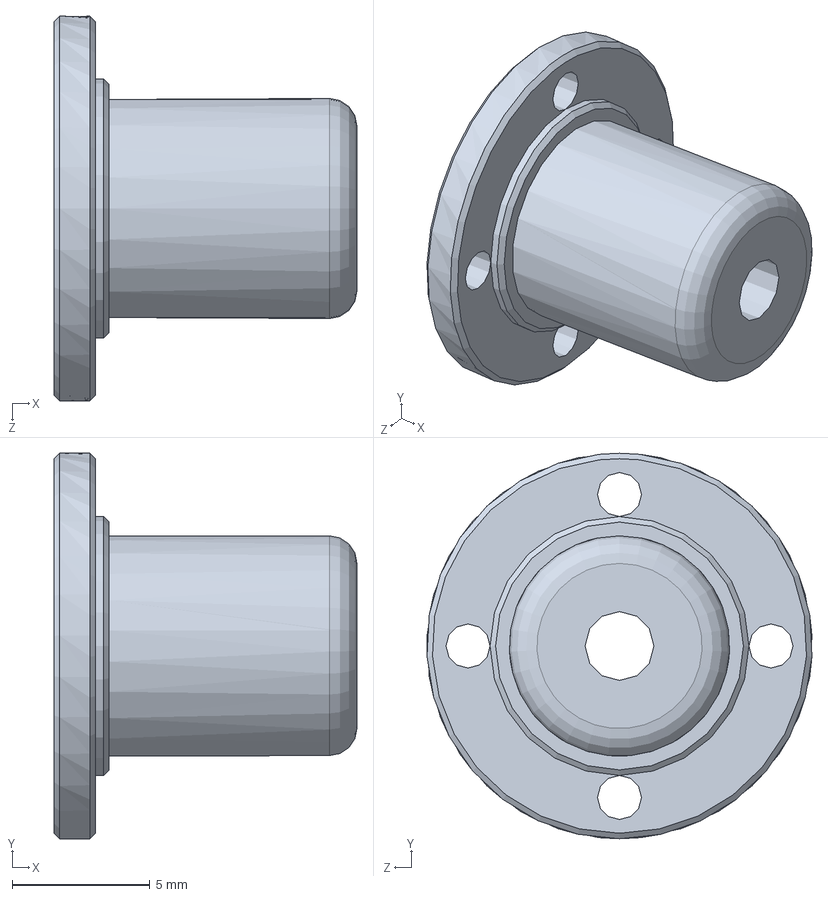
[picture p66: CAD file, 2024-12-04]
1_Mechanic/Alexbotmini(SW2URDF)/1_Lowerbody/GR1-07-2-033,关节延长轴_copy.SLDPRT
11.0 x 14.0 x 14.0 mm
