Alexhuge1/Alexbotmini_hardware/1_Mechanic/Alexbotmini(SW2URDF)/2_Wholebody/M10导向轴_80.SLDPRT

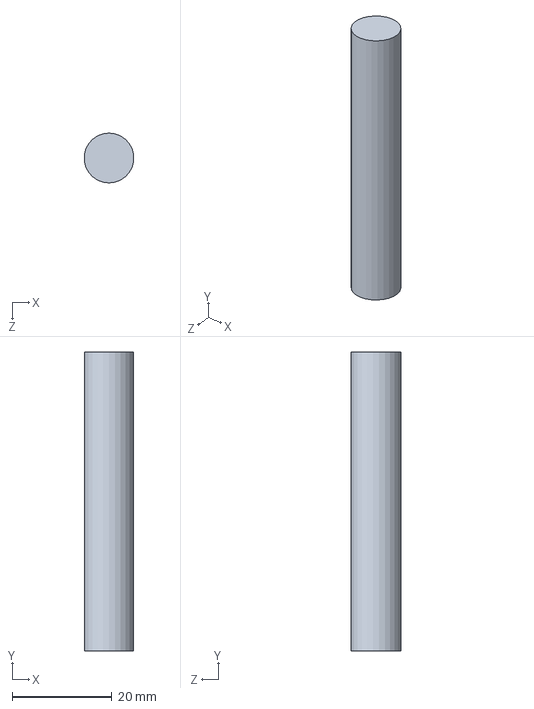
[picture p67: CAD file, 2024-12-04]
1_Mechanic/Alexbotmini(SW2URDF)/2_Wholebody/M10导向轴_80.SLDPRT
9.93 x 60.0 x 10.0 mm
