Alexhuge1/Alexbotmini_hardware/1_Mechanic/Alexbotmini(SW2URDF)/1_Lowerbody/GR1-07-2-017-G,脚板连杆座_copy.SLDPRT

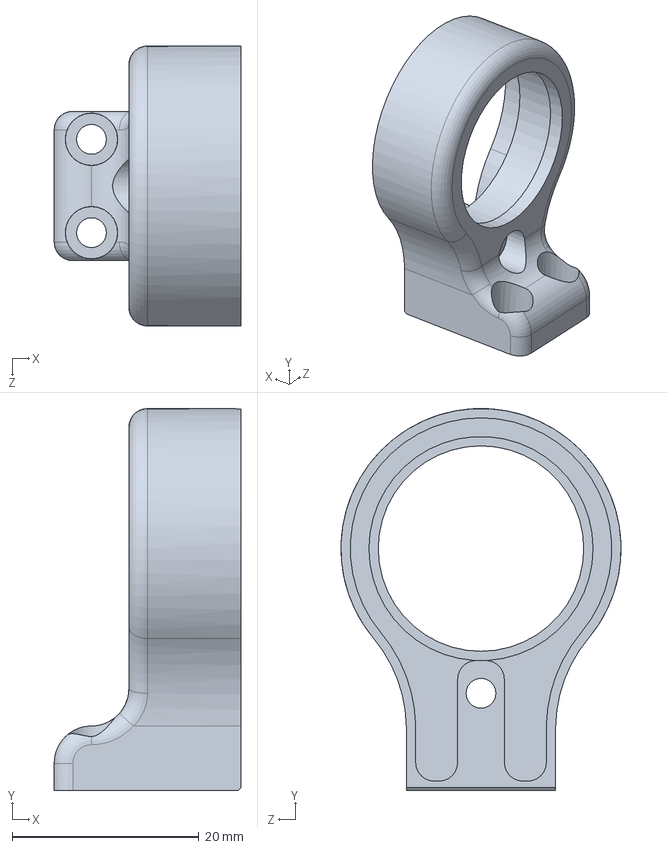
[picture p68: CAD file, 2024-12-04]
1_Mechanic/Alexbotmini(SW2URDF)/1_Lowerbody/GR1-07-2-017-G,脚板连杆座_copy.SLDPRT
20.0 x 40.9 x 30.0 mm
