Alexhuge1/Alexbotmini_hardware/1_Mechanic/Alexbotmini(SW2URDF)/2_Wholebody/thigh2.SLDPRT

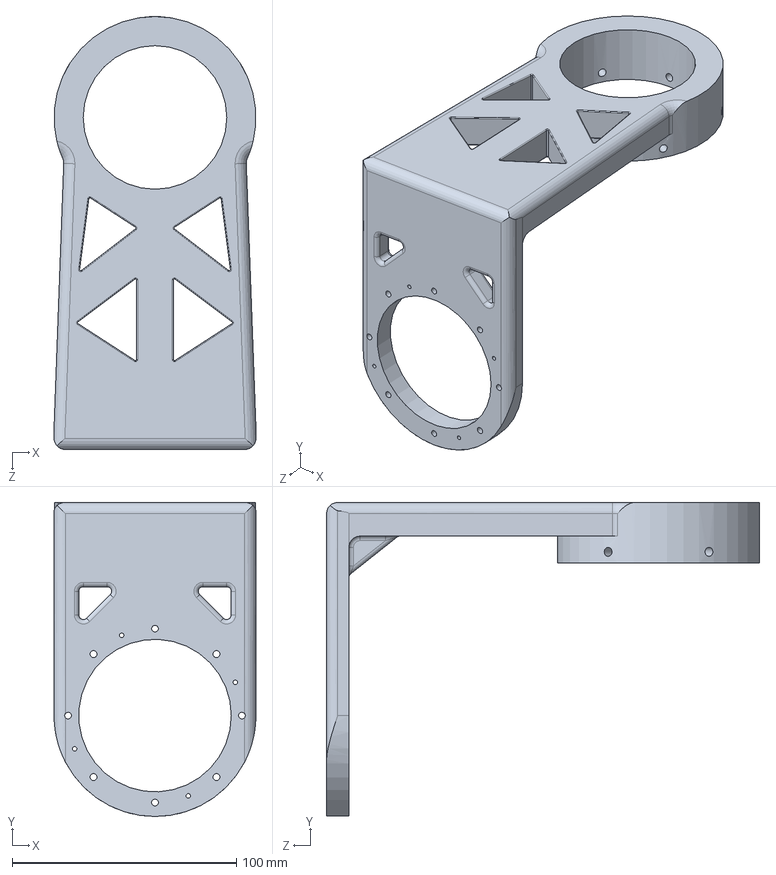
[picture p69: CAD file, 2024-12-04]
1_Mechanic/Alexbotmini(SW2URDF)/2_Wholebody/thigh2.SLDPRT
90.0 x 140.0 x 193.0 mm
