Alexhuge1/Alexbotmini_hardware/1_Mechanic/Alexbotmini(SW2URDF)/3_For_CNC/step/fsa45_30_output.step

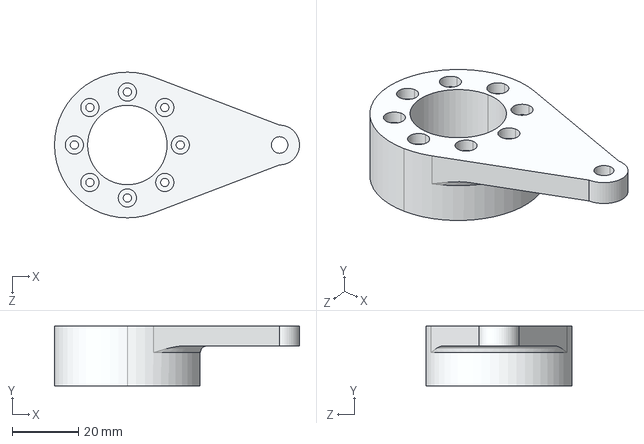
[picture p70: CAD file, 2024-12-04]
1_Mechanic/Alexbotmini(SW2URDF)/3_For_CNC/step/fsa45_30_output.step
74.0 x 18.0 x 44.0 mm
