Alexhuge1/Alexbotmini_hardware/1_Mechanic/Alexbotmini(SW2URDF)/2_Wholebody/转压.SLDPRT

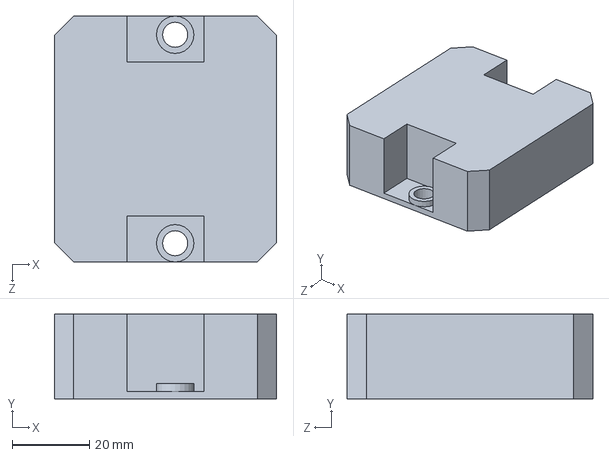
[picture p71: CAD file, 2024-12-04]
1_Mechanic/Alexbotmini(SW2URDF)/2_Wholebody/转压.SLDPRT
57.6 x 22.0 x 63.7 mm
