Alexhuge1/Alexbotmini_hardware/1_Mechanic/Alexbotmini(SW2URDF)/2_Wholebody/M10导向轴_140.SLDPRT

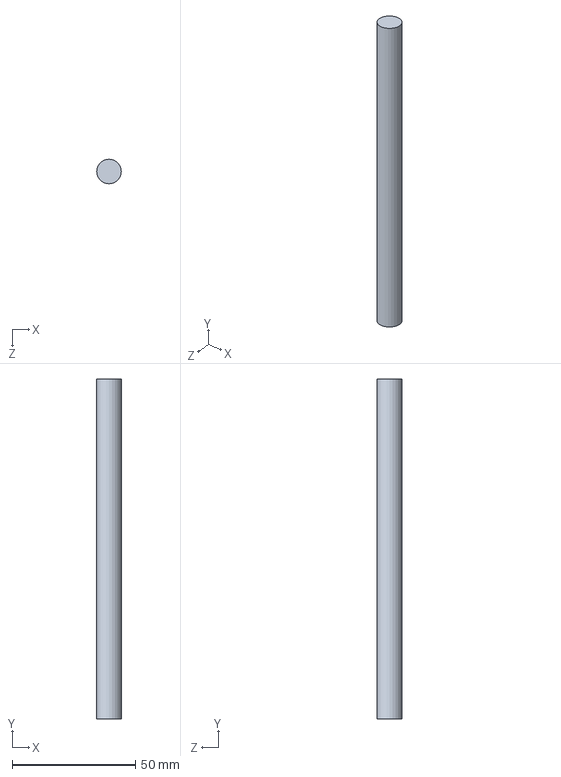
[picture p72: CAD file, 2024-12-04]
1_Mechanic/Alexbotmini(SW2URDF)/2_Wholebody/M10导向轴_140.SLDPRT
10.0 x 138.0 x 10.0 mm
