Alexhuge1/Alexbotmini_hardware/1_Mechanic/Alexbotmini(SW2URDF)/2_Wholebody/HI14_M12_Angled(弯头).STEP

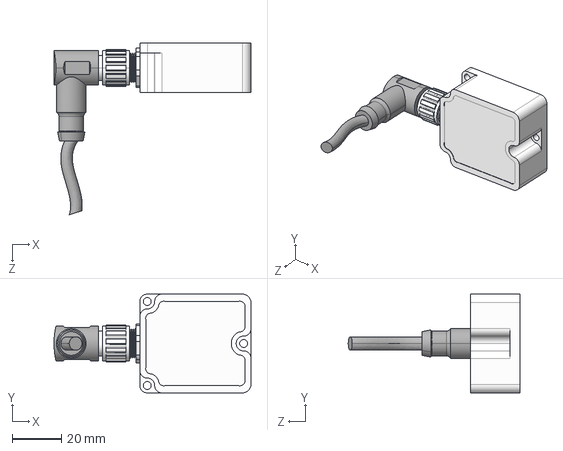
[picture p73: CAD file, 2024-12-04]
1_Mechanic/Alexbotmini(SW2URDF)/2_Wholebody/HI14_M12_Angled(弯头).STEP
79.8 x 40.0 x 69.5 mm
