Alexhuge1/Alexbotmini_hardware/1_Mechanic/Alexbotmini(SW2URDF)/2_Wholebody/M10导向轴.SLDPRT

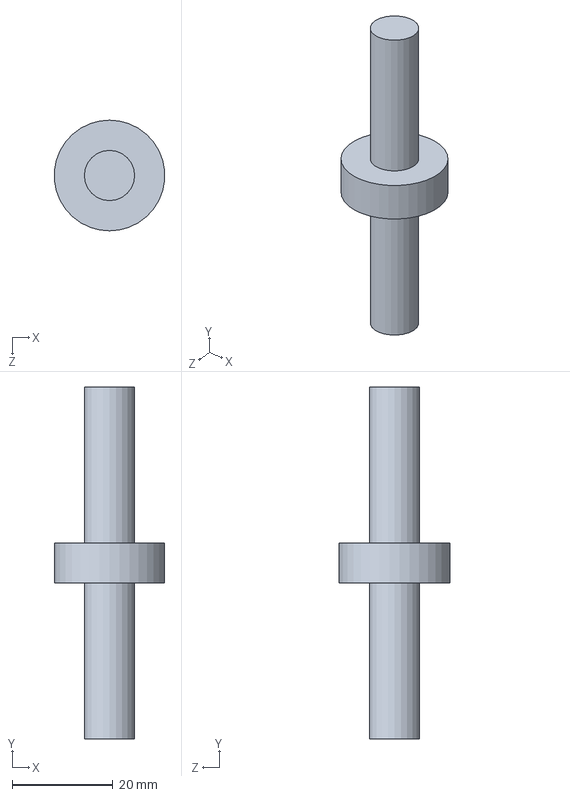
[picture p74: CAD file, 2024-12-04]
1_Mechanic/Alexbotmini(SW2URDF)/2_Wholebody/M10导向轴.SLDPRT
21.9 x 69.9 x 22.0 mm
