Alexhuge1/Alexbotmini_hardware/1_Mechanic/Alexbotmini(SW2URDF)/1_Lowerbody/GR1-07-2-034-G,脚板十字座_copy.SLDPRT

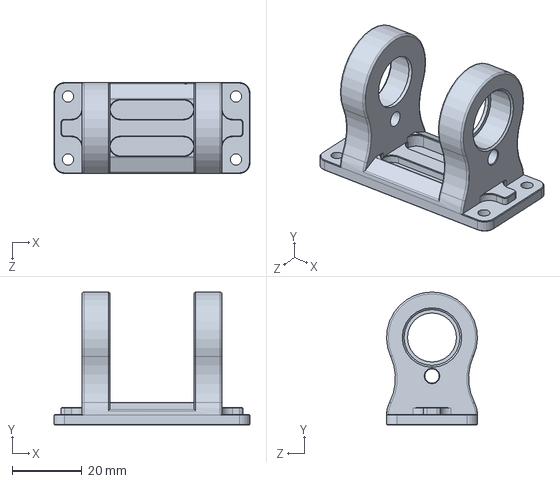
[picture p75: CAD file, 2024-12-04]
1_Mechanic/Alexbotmini(SW2URDF)/1_Lowerbody/GR1-07-2-034-G,脚板十字座_copy.SLDPRT
56.0 x 38.0 x 26.0 mm
