Alexhuge1/Alexbotmini_hardware/1_Mechanic/Alexbotmini(SW2URDF)/2_Wholebody/M4螺柱6.SLDPRT

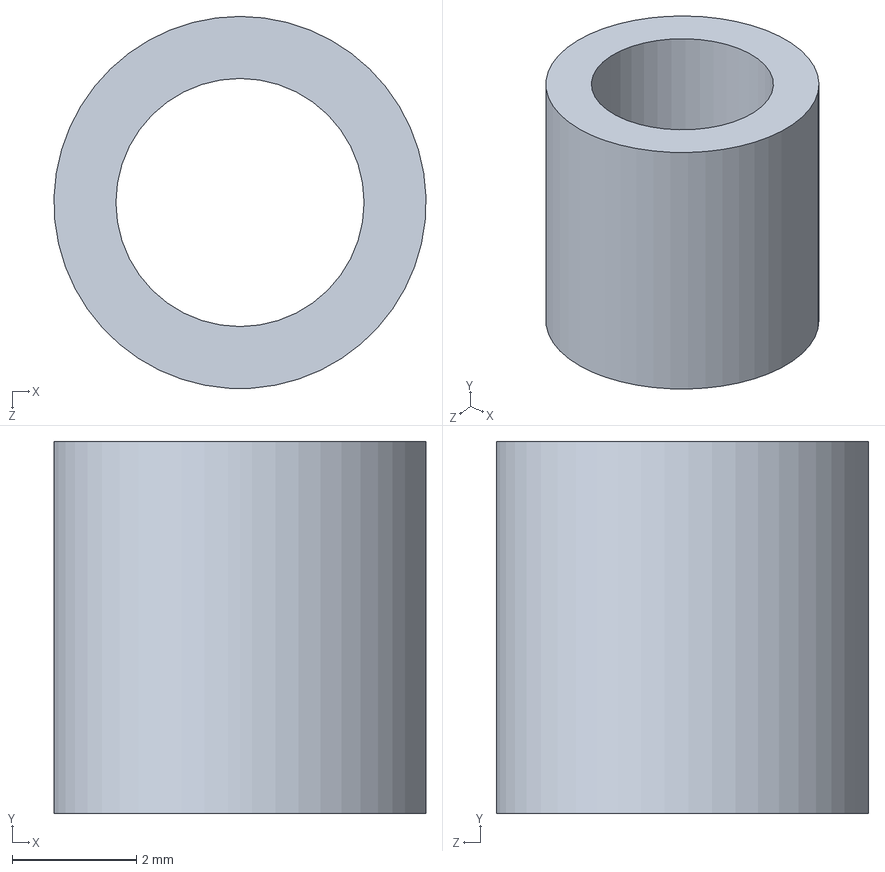
[picture p76: CAD file, 2024-12-04]
1_Mechanic/Alexbotmini(SW2URDF)/2_Wholebody/M4螺柱6.SLDPRT
6.00 x 6.00 x 6.00 mm
