Alexhuge1/Alexbotmini_hardware/1_Mechanic/Alexbotmini(SW2URDF)/1_Lowerbody/SC-BEAR-6802-ZZ,深沟球轴承6802_copy.SLDPRT

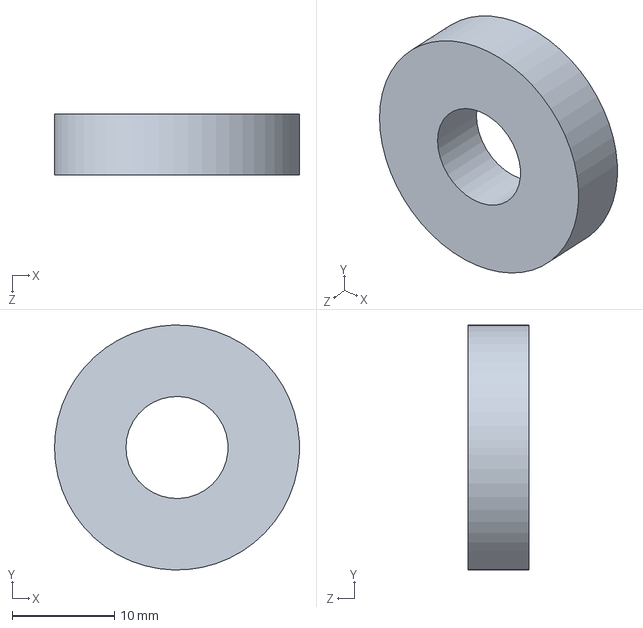
[picture p77: CAD file, 2024-12-04]
1_Mechanic/Alexbotmini(SW2URDF)/1_Lowerbody/SC-BEAR-6802-ZZ,深沟球轴承6802_copy.SLDPRT
24.0 x 24.0 x 6.00 mm
