Alexhuge1/Alexbotmini_hardware/1_Mechanic/Alexbotmini(SW2URDF)/1_Lowerbody/SC-BEAR-628-8,深沟球轴承628-8_copy.SLDPRT

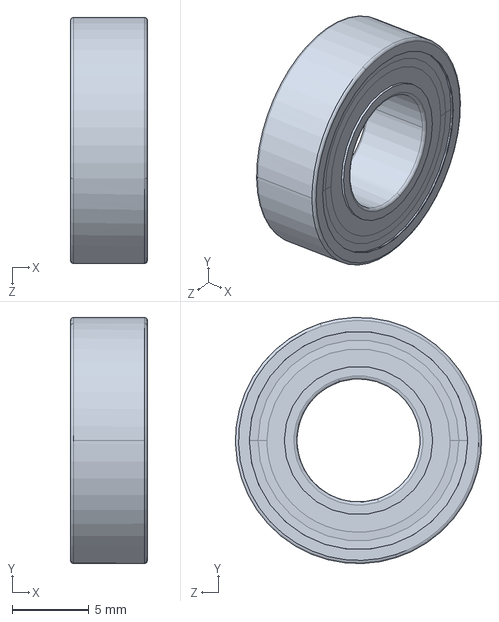
[picture p78: CAD file, 2024-12-04]
1_Mechanic/Alexbotmini(SW2URDF)/1_Lowerbody/SC-BEAR-628-8,深沟球轴承628-8_copy.SLDPRT
5.00 x 16.0 x 16.0 mm
