Alexhuge1/Alexbotmini_hardware/1_Mechanic/Alexbotmini(SW2URDF)/2_Wholebody/fsa80_29e_output.SLDPRT

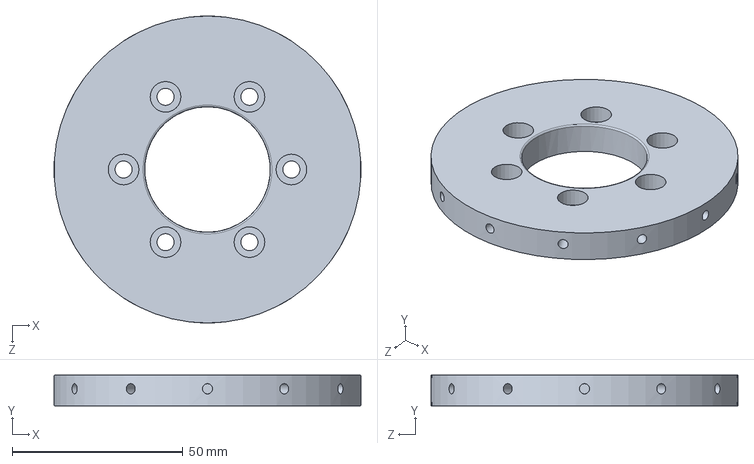
[picture p79: CAD file, 2024-12-04]
1_Mechanic/Alexbotmini(SW2URDF)/2_Wholebody/fsa80_29e_output.SLDPRT
90.0 x 9.00 x 90.0 mm
