Alexhuge1/Alexbotmini_hardware/1_Mechanic/Alexbotmini(SW2URDF)/2_Wholebody/battery.SLDPRT

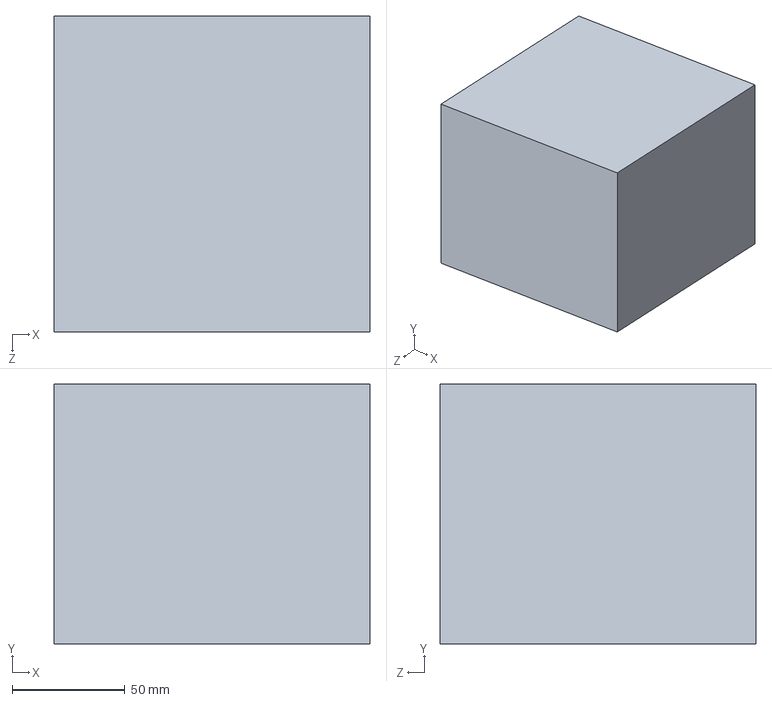
[picture p80: CAD file, 2024-12-04]
1_Mechanic/Alexbotmini(SW2URDF)/2_Wholebody/battery.SLDPRT
140.0 x 115.0 x 140.0 mm
