Alexhuge1/Alexbotmini_hardware/1_Mechanic/Alexbotmini(SW2URDF)/2_Wholebody/back.SLDPRT

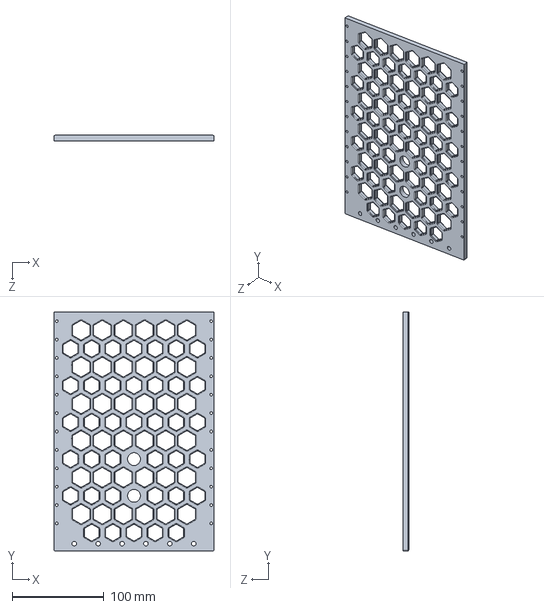
[picture p81: CAD file, 2024-12-04]
1_Mechanic/Alexbotmini(SW2URDF)/2_Wholebody/back.SLDPRT
174.0 x 260.0 x 6.00 mm
