Alexhuge1/Alexbotmini_hardware/1_Mechanic/Alexbotmini(SW2URDF)/2_Wholebody/M3螺柱25.SLDPRT

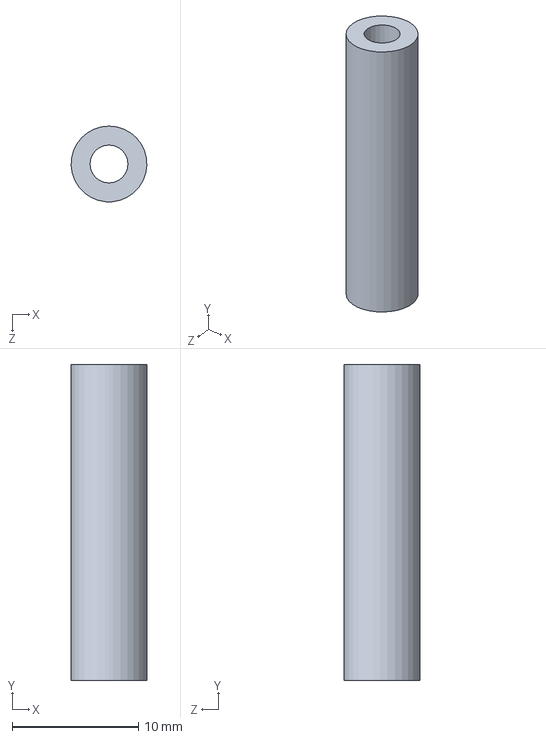
[picture p82: CAD file, 2024-12-04]
1_Mechanic/Alexbotmini(SW2URDF)/2_Wholebody/M3螺柱25.SLDPRT
5.99 x 25.0 x 6.00 mm
