Alexhuge1/Alexbotmini_hardware/1_Mechanic/Alexbotmini(SW2URDF)/2_Wholebody/M8螺柱.SLDPRT

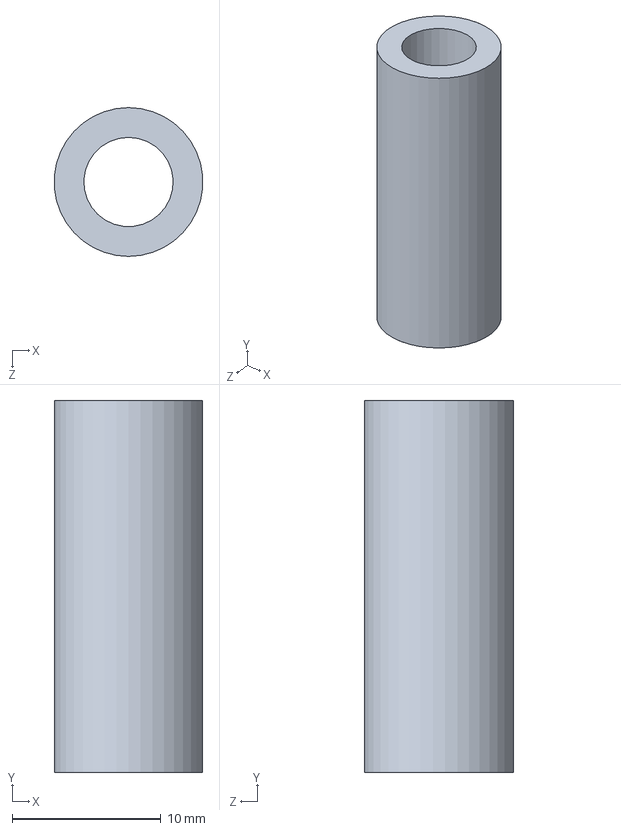
[picture p83: CAD file, 2024-12-04]
1_Mechanic/Alexbotmini(SW2URDF)/2_Wholebody/M8螺柱.SLDPRT
9.97 x 25.0 x 10.0 mm
