Alexhuge1/Alexbotmini_hardware/1_Mechanic/Alexbotmini(SW2URDF)/2_Wholebody/M6螺柱35.SLDPRT

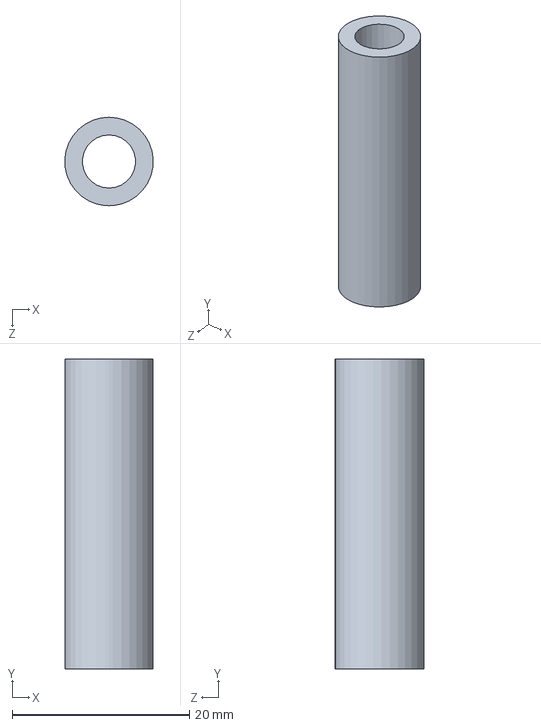
[picture p84: CAD file, 2024-12-04]
1_Mechanic/Alexbotmini(SW2URDF)/2_Wholebody/M6螺柱35.SLDPRT
9.99 x 35.0 x 10.0 mm
