Alexhuge1/Alexbotmini_hardware/1_Mechanic/Alexbotmini(SW2URDF)/1_Lowerbody/GR1-07-2-048,左脚包胶足撑_copy.SLDASM

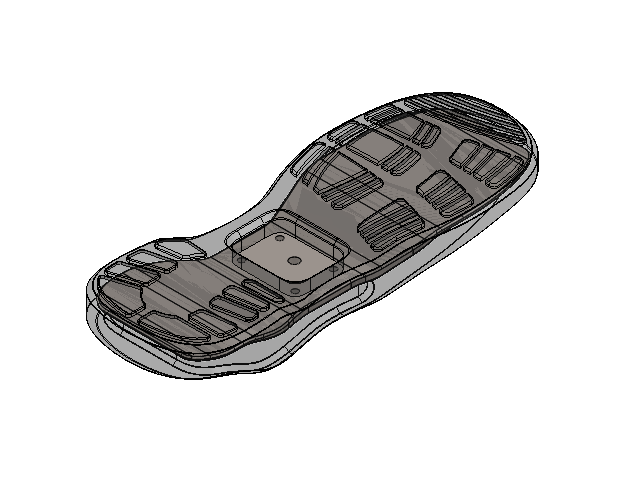
[picture p85: CAD file, 2024-12-04]
1_Mechanic/Alexbotmini(SW2URDF)/1_Lowerbody/GR1-07-2-048,左脚包胶足撑_copy.SLDASM
碳纤维板_copy
硅胶脚0418_copy
