Alexhuge1/Alexbotmini_hardware/1_Mechanic/Alexbotmini(SW2URDF)/1_Lowerbody/GR1-06-2-048,右脚包胶足撑_copy.SLDASM

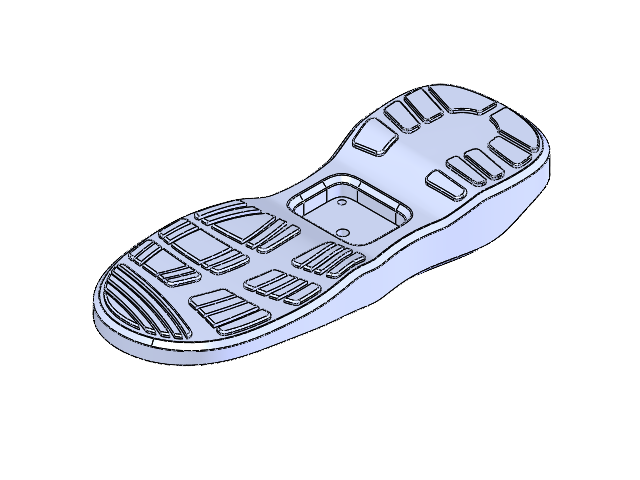
[picture p86: CAD file, 2024-12-04]
1_Mechanic/Alexbotmini(SW2URDF)/1_Lowerbody/GR1-06-2-048,右脚包胶足撑_copy.SLDASM
镜向碳纤维板_copy
镜向硅胶脚0418_copy
