Alexhuge1/Alexbotmini_hardware/(list of files, cad)

Other CAD files:
1_Mechanic/Alexbotmini(SW2URDF)/2_Wholebody/左小腿组件_copy.SLDASM
1_Mechanic/Alexbotmini(SW2URDF)/2_Wholebody/GR1-07-2-048,左脚包胶足撑_copy.SLDASM
1_Mechanic/Alexbotmini(SW2URDF)/2_Wholebody/GR1-06-2-048,右脚包胶足撑_copy.SLDASM
1_Mechanic/Alexbotmini(SW2URDF)/3_For_CNC/3D/back.SLDPRT
1_Mechanic/Alexbotmini(SW2URDF)/3_For_CNC/3D/right.SLDPRT
1_Mechanic/Alexbotmini(SW2URDF)/3_For_CNC/step/calf1.step
1_Mechanic/Alexbotmini(SW2URDF)/1_Lowerbody/镜向碳纤维板_copy.SLDPRT
1_Mechanic/Alexbotmini(SW2URDF)/3_For_CNC/step/fsa60_43e_output.STEP
1_Mechanic/Alexbotmini(SW2URDF)/3_For_CNC/step/thigh1.STEP
1_Mechanic/Alexbotmini(SW2URDF)/3_For_CNC/step/thigh2.STEP
1_Mechanic/Alexbotmini(SW2URDF)/2_Wholebody/fsa80_29e_output_long.SLDPRT
1_Mechanic/Alexbotmini(SW2URDF)/1_Lowerbody/fsa80_29e_output_long.SLDPRT
1_Mechanic/Alexbotmini(SW2URDF)/1_Lowerbody/thigh2.SLDPRT
1_Mechanic/Alexbotmini(SW2URDF)/1_Lowerbody/fsa80_29e_output.SLDPRT
1_Mechanic/Alexbotmini(SW2URDF)/1_Lowerbody/thigh1.SLDPRT
1_Mechanic/Alexbotmini(SW2URDF)/1_Lowerbody/knee.SLDPRT
1_Mechanic/Alexbotmini(SW2URDF)/2_Wholebody/knee.SLDPRT
1_Mechanic/Alexbotmini(SW2URDF)/1_Lowerbody/crotch.SLDPRT
1_Mechanic/Alexbotmini(SW2URDF)/1_Lowerbody/M10导向轴.SLDPRT
1_Mechanic/Alexbotmini(SW2URDF)/2_Wholebody/right.SLDPRT
1_Mechanic/Alexbotmini(SW2URDF)/2_Wholebody/imu.SLDPRT
1_Mechanic/Alexbotmini(SW2URDF)/2_Wholebody/crotch.SLDPRT
1_Mechanic/Alexbotmini(SW2URDF)/2_Wholebody/front.SLDPRT
1_Mechanic/Alexbotmini(SW2URDF)/1_Lowerbody/GR1-07-2-059-G,脚板连杆座-1_copy.SLDPRT
1_Mechanic/Alexbotmini(SW2URDF)/2_Wholebody/GR1-07-2-059-G,脚板连杆座-1_copy.SLDPRT
1_Mechanic/Alexbotmini(SW2URDF)/2_Wholebody/镜向碳纤维板_copy.SLDPRT
1_Mechanic/Alexbotmini(SW2URDF)/2_Wholebody/left.SLDPRT
1_Mechanic/Alexbotmini(SW2URDF)/2_Wholebody/GR1-07-2-030,踝十字轴_copy.SLDPRT
1_Mechanic/Alexbotmini(SW2URDF)/1_Lowerbody/calf1 - 副本.SLDPRT
1_Mechanic/Alexbotmini(SW2URDF)/2_Wholebody/calf1 - 副本.SLDPRT
1_Mechanic/Alexbotmini(SW2URDF)/3_For_CNC/2D/back.SLDDRW
1_Mechanic/Alexbotmini(SW2URDF)/3_For_CNC/2D/calf1 - 副本.SLDDRW
1_Mechanic/Alexbotmini(SW2URDF)/3_For_CNC/2D/calf1.SLDDRW
1_Mechanic/Alexbotmini(SW2URDF)/3_For_CNC/2D/crotch.SLDDRW
1_Mechanic/Alexbotmini(SW2URDF)/3_For_CNC/2D/ctrlbox.SLDDRW
1_Mechanic/Alexbotmini(SW2URDF)/3_For_CNC/2D/front.SLDDRW
1_Mechanic/Alexbotmini(SW2URDF)/3_For_CNC/2D/fsa45_30_output.SLDDRW
1_Mechanic/Alexbotmini(SW2URDF)/3_For_CNC/2D/fsa60_43e_output.SLDDRW
1_Mechanic/Alexbotmini(SW2URDF)/3_For_CNC/2D/fsa80_29e_output.SLDDRW
1_Mechanic/Alexbotmini(SW2URDF)/3_For_CNC/2D/fsa80_29e_output_long.SLDDRW
1_Mechanic/Alexbotmini(SW2URDF)/3_For_CNC/2D/knee.SLDDRW
1_Mechanic/Alexbotmini(SW2URDF)/3_For_CNC/2D/left.SLDDRW
1_Mechanic/Alexbotmini(SW2URDF)/3_For_CNC/2D/right.SLDDRW
1_Mechanic/Alexbotmini(SW2URDF)/3_For_CNC/2D/thigh1.SLDDRW
1_Mechanic/Alexbotmini(SW2URDF)/3_For_CNC/2D/thigh2.SLDDRW
1_Mechanic/Alexbotmini(SW2URDF)/3_For_CNC/2D/top.SLDDRW
1_Mechanic/Alexbotmini(SW2URDF)/3_For_CNC/3D/calf1 - 副本.SLDPRT
1_Mechanic/Alexbotmini(SW2URDF)/3_For_CNC/3D/calf1.SLDPRT
1_Mechanic/Alexbotmini(SW2URDF)/3_For_CNC/3D/crotch.SLDPRT
1_Mechanic/Alexbotmini(SW2URDF)/3_For_CNC/3D/fsa45_30_output.SLDPRT
1_Mechanic/Alexbotmini(SW2URDF)/3_For_CNC/3D/fsa80_29e_output.SLDPRT
1_Mechanic/Alexbotmini(SW2URDF)/3_For_CNC/3D/fsa80_29e_output_long.SLDPRT
1_Mechanic/Alexbotmini(SW2URDF)/3_For_CNC/3D/knee.SLDPRT
1_Mechanic/Alexbotmini(SW2URDF)/3_For_CNC/3D/thigh1.SLDPRT
1_Mechanic/Alexbotmini(SW2URDF)/3_For_CNC/3D/thigh2.SLDPRT
1_Mechanic/Alexbotmini(SW2URDF)/3_For_CNC/step/calf1 - 副本.step
