Alexhuge1/Alexbotmini_hardware/1_Mechanic/Alexbotmini_website/instructions.html

## Instructions for sharing KeyShotXR

Below is your KeyShotXR. To view the KeyShotXR by itself open the keyshot.23.html file in the keyshot.23 folder.

## Uploading to and displaying on your website:

Upload the 'keyshot.23' folder with all of its contents to your webserver. Copy (Ctrl-C/Cmd-C) and Paste (Ctrl-V/Cmd-V) the code below to your webpage.

[Code]:

<div style="max-width: 1921px; max-height: 1052px;">
  <div style="left: 0px; width: 100%; height: 0px; position: relative; padding-bottom: 54.7631%; overflow: hidden;">
    <iframe src="keyshot.23.html"
                 allowfullscreen
                 style="position: absolute; top: 0px; left: 0px; height: 100%; width: 1px; min-width: 100%; *width: 100%;"
                 frameborder="0"
                 scrolling="no">
    </iframe>
  </div>
</div>

If you share your KeyShotXR via email, send the entire zipped 'keyshot.23' folder to the recipient(s).
