Alexhuge1/Alexbotmini_hardware/(commit log)

2024-12-04 add alexbotmini develop file
    add alexbotmini develop file
    [BOM.xlsx, GR1-06-2-048,右脚包胶足撑_copy.SLDASM, GR1-07-2-017-G,脚板连杆座_copy.SLDPRT, GR1-07-2-030,踝十字轴_copy.SLDPRT, GR1-07-2-033,关节延长轴_copy.SLDPRT, GR1-07-2-034-G,脚板十字座_copy.SLDPRT, GR1-07-2-048,左脚包胶足撑_copy.SLDASM, GR1-07-2-049-G,脚板转接件_copy.SLDPRT]
2024-12-05 First release of alexbotmini
    First release of alexbotmini
    [BOM.xlsx, GR1-06-2-048,右脚包胶足撑_copy.SLDASM, GR1-07-2-017-G,脚板连杆座_copy.SLDPRT, GR1-07-2-030,踝十字轴_copy.SLDPRT, GR1-07-2-033,关节延长轴_copy.SLDPRT, GR1-07-2-034-G,脚板十字座_copy.SLDPRT, GR1-07-2-048,左脚包胶足撑_copy.SLDASM, GR1-07-2-049-G,脚板转接件_copy.SLDPRT]
2025-01-13 small change in urdf
    small change in urdf
    [BOM.xlsx, GR1-06-2-048,右脚包胶足撑_copy.SLDASM, GR1-07-2-017-G,脚板连杆座_copy.SLDPRT, GR1-07-2-030,踝十字轴_copy.SLDPRT, GR1-07-2-033,关节延长轴_copy.SLDPRT, GR1-07-2-034-G,脚板十字座_copy.SLDPRT, GR1-07-2-048,左脚包胶足撑_copy.SLDASM, GR1-07-2-049-G,脚板转接件_copy.SLDPRT]
2025-01-23 add sw2urdf
    add sw2urdf
    [BOM.xlsx, GR1-06-2-048,右脚包胶足撑_copy.SLDASM, GR1-07-2-017-G,脚板连杆座_copy.SLDPRT, GR1-07-2-030,踝十字轴_copy.SLDPRT, GR1-07-2-033,关节延长轴_copy.SLDPRT, GR1-07-2-034-G,脚板十字座_copy.SLDPRT, GR1-07-2-048,左脚包胶足撑_copy.SLDASM, GR1-07-2-049-G,脚板转接件_copy.SLDPRT]
2025-01-24 add urdf_refine
    add urdf_refine
    [urdf_refine(mustread)！.xlsx]
2025-02-18 small change add some photos and pdf
    [GR1-07-2-030,踝十字轴_copy.SLDPRT, 左小腿组件_copy.SLDASM]
