Alexhuge1/Alexbotmini_hardware/(notices)

Notices in the files:
1_Mechanic/Alexbotmini_website/instructions.html:
(c) Copyright 2012-2017 Luxion ApS - All Rights Reserved.
